z2901550610/Min_Sum/docs/figures/c2v_state_read_pipeline.png

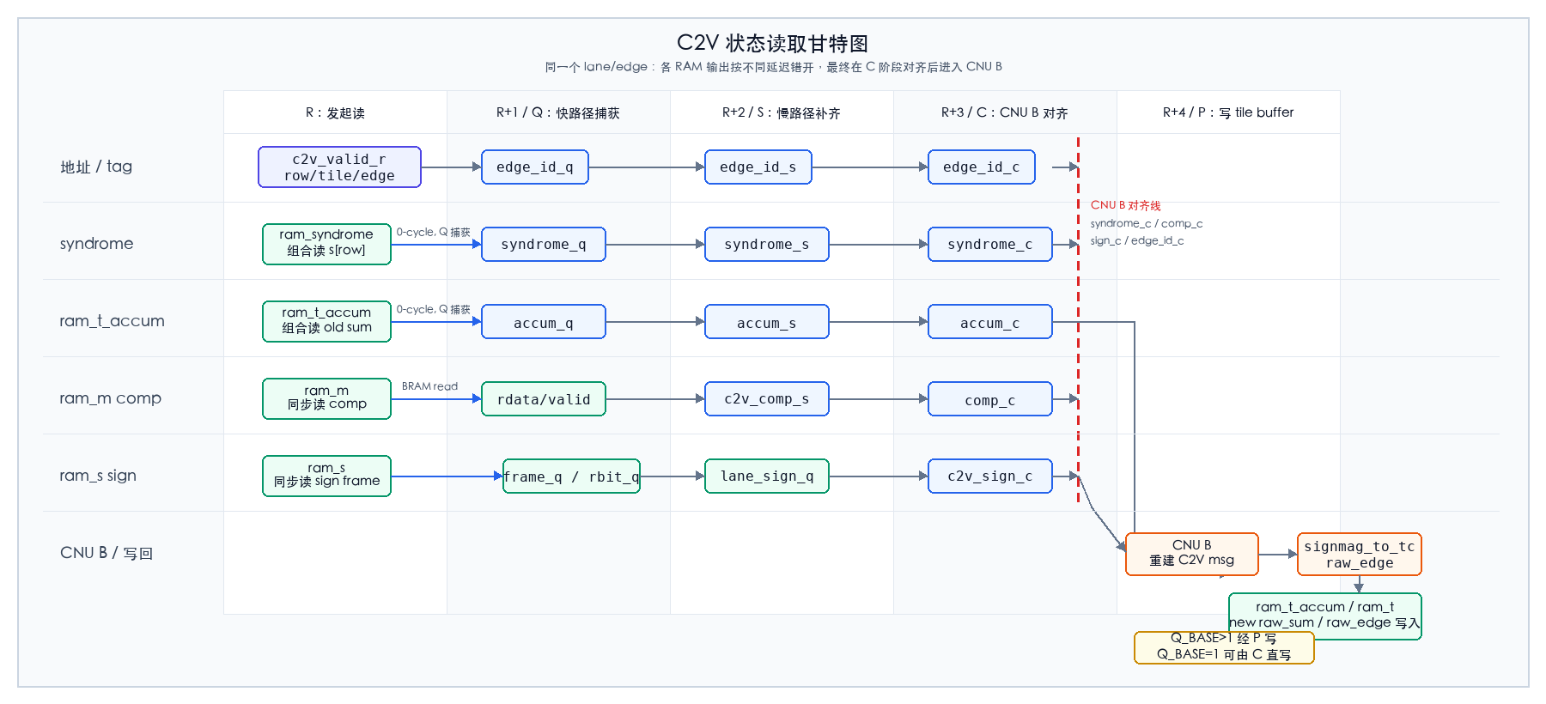
docs/figures/c2v_state_read_pipeline.png
