z2901550610/Min_Sum/docs/figures/decoder_datapath.png

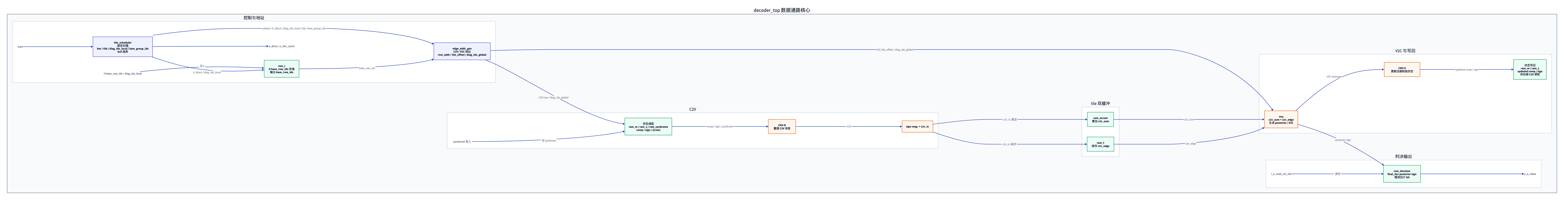
docs/figures/decoder_datapath.png
