z2901550610/Min_Sum/docs/figures/scheduler_window_pipeline.png

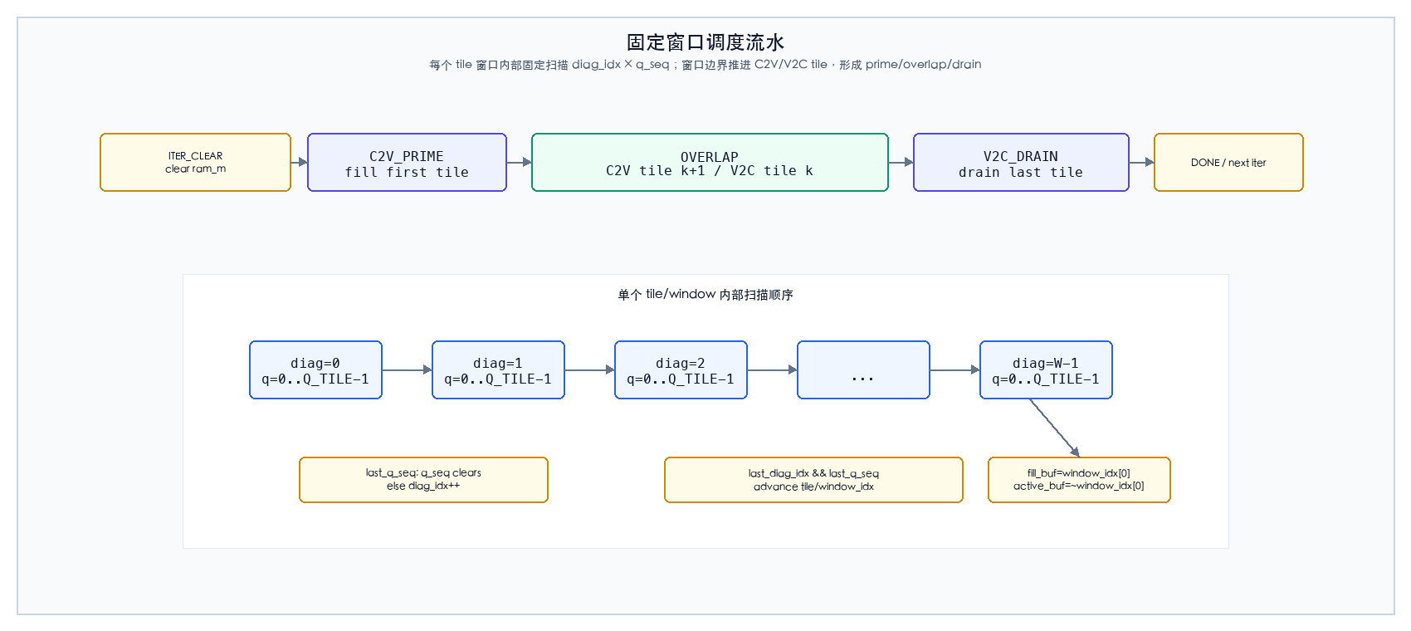
docs/figures/scheduler_window_pipeline.png
