z2901550610/Min_Sum/docs/figures/tile_buffer_pingpong.png

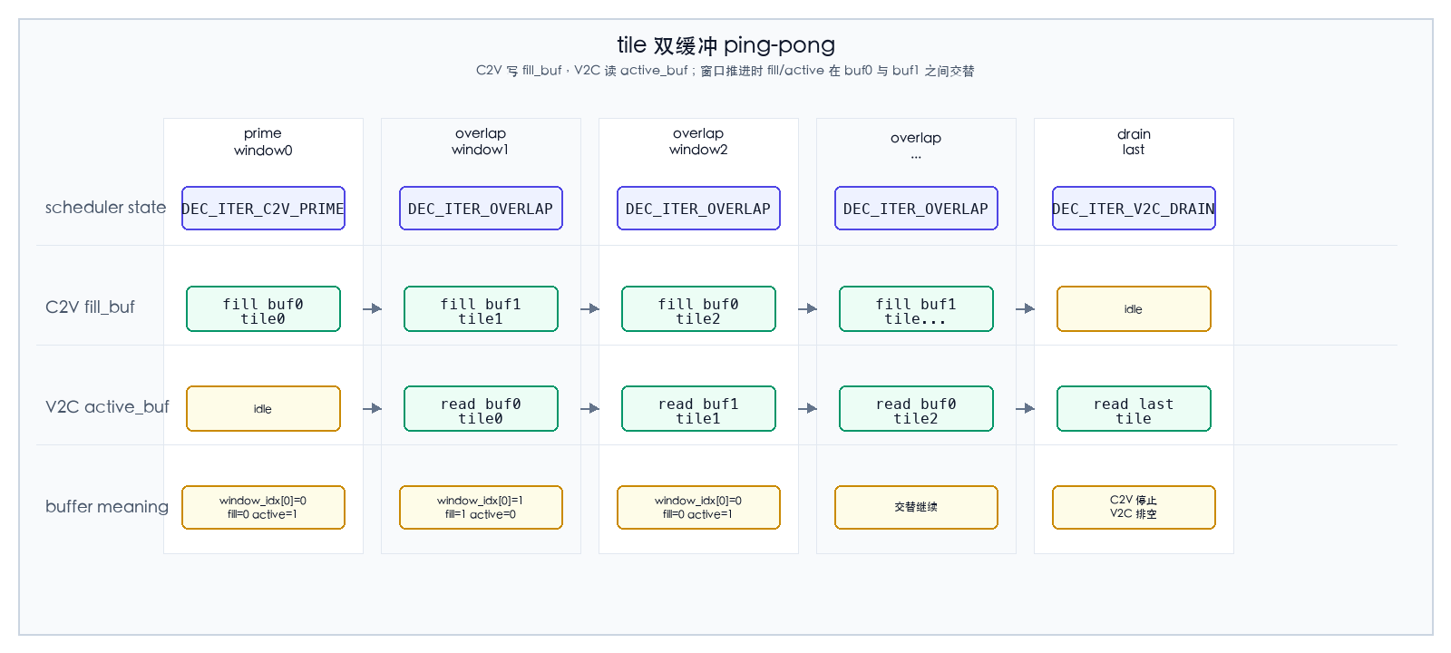
docs/figures/tile_buffer_pingpong.png
