z2901550610/Min_Sum/docs/figures/trike160_full_ksign_k3_k4_logdfr.png

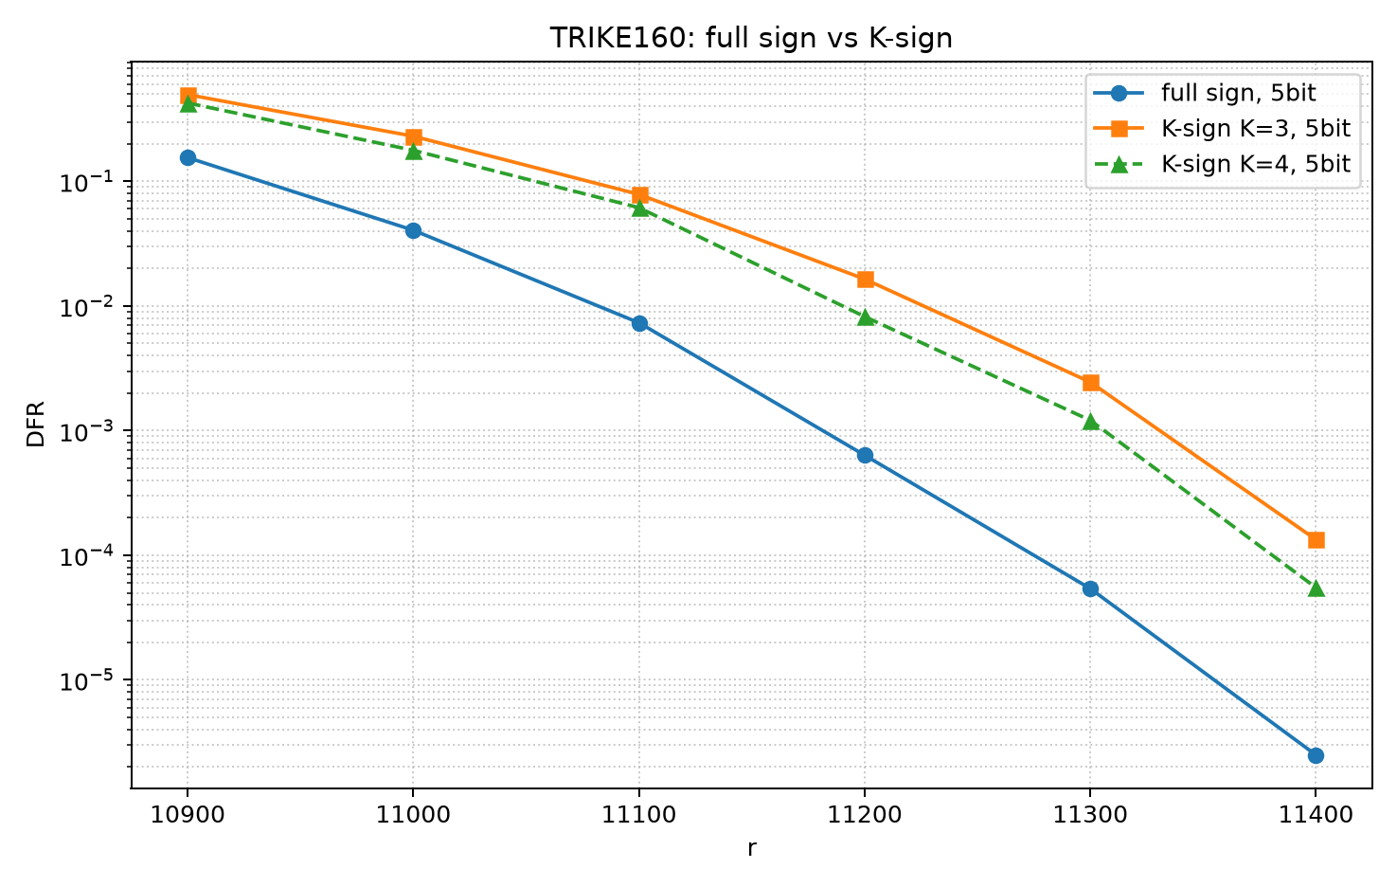
docs/figures/trike160_full_ksign_k3_k4_logdfr.png
