z2901550610/Min_Sum/docs/figures/trike384_full_ksign_k3_k4_logdfr.png

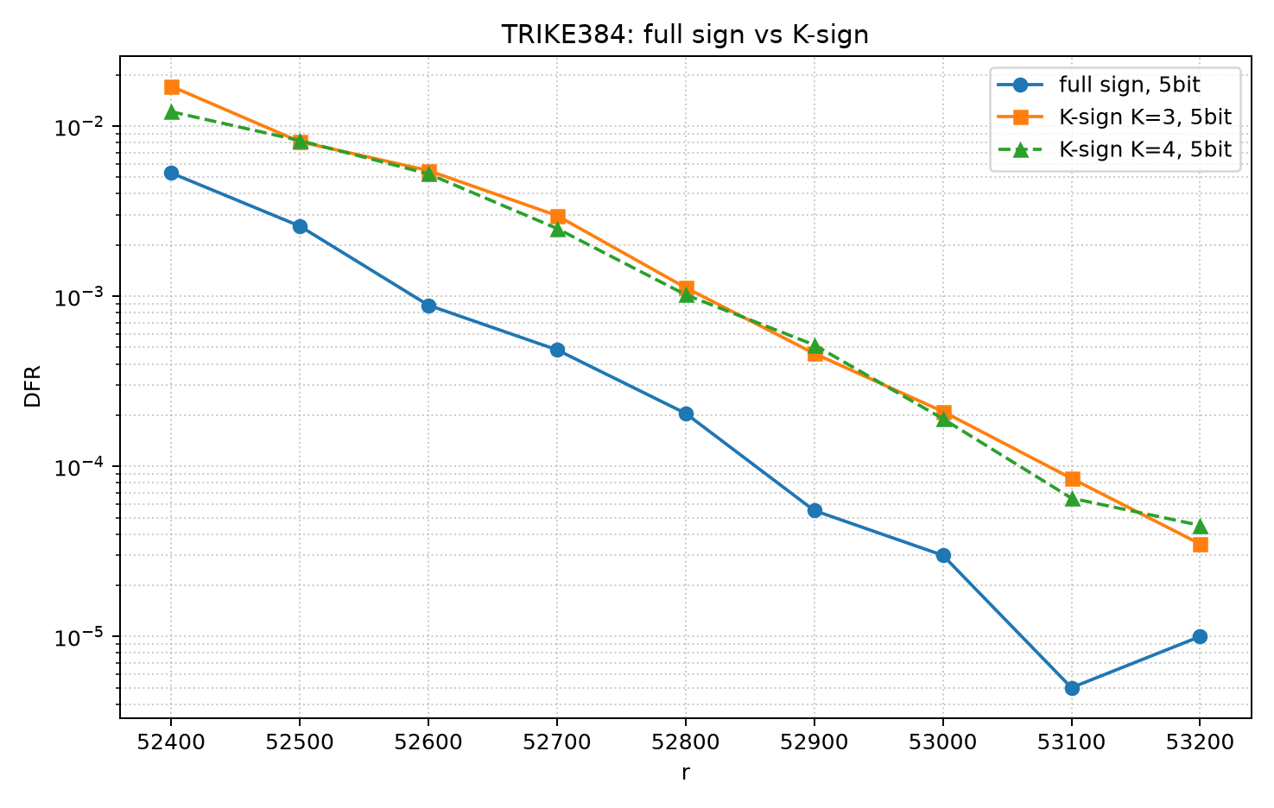
docs/figures/trike384_full_ksign_k3_k4_logdfr.png
