z2901550610/Min_Sum/docs/figures/trike512_full_k6_k4_logdfr_no_upper.png

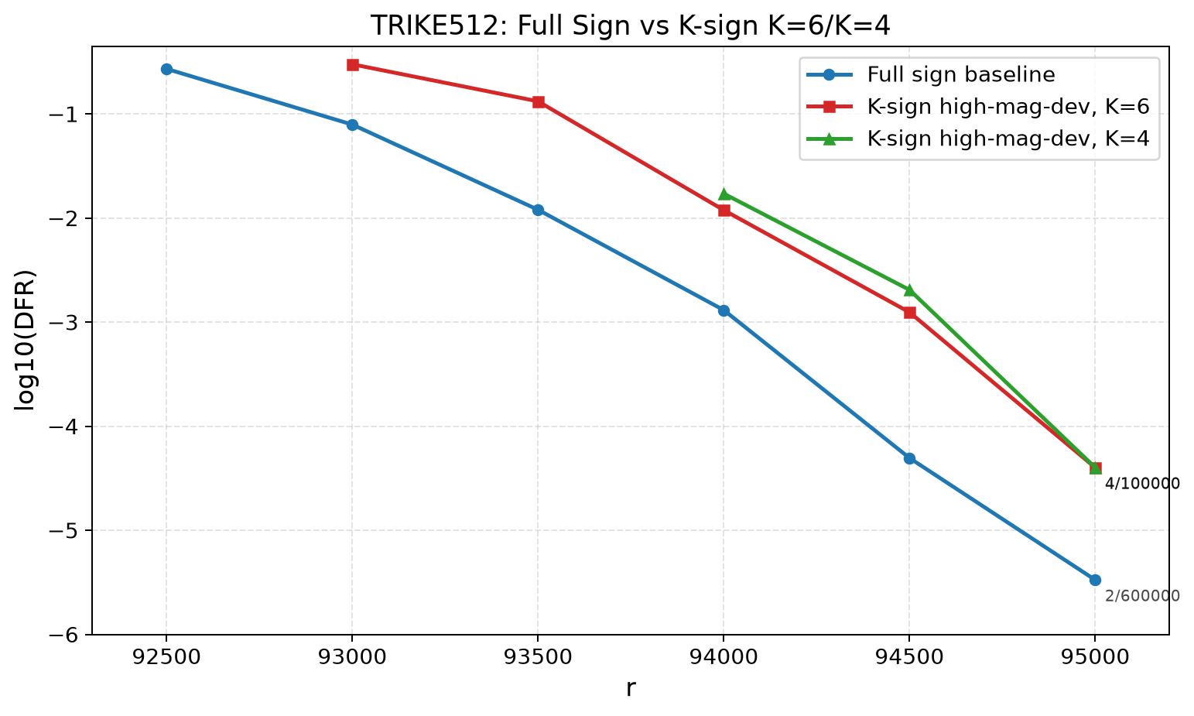
docs/figures/trike512_full_k6_k4_logdfr_no_upper.png
