z2901550610/Min_Sum/docs/figures/v2c_update_pipeline.png

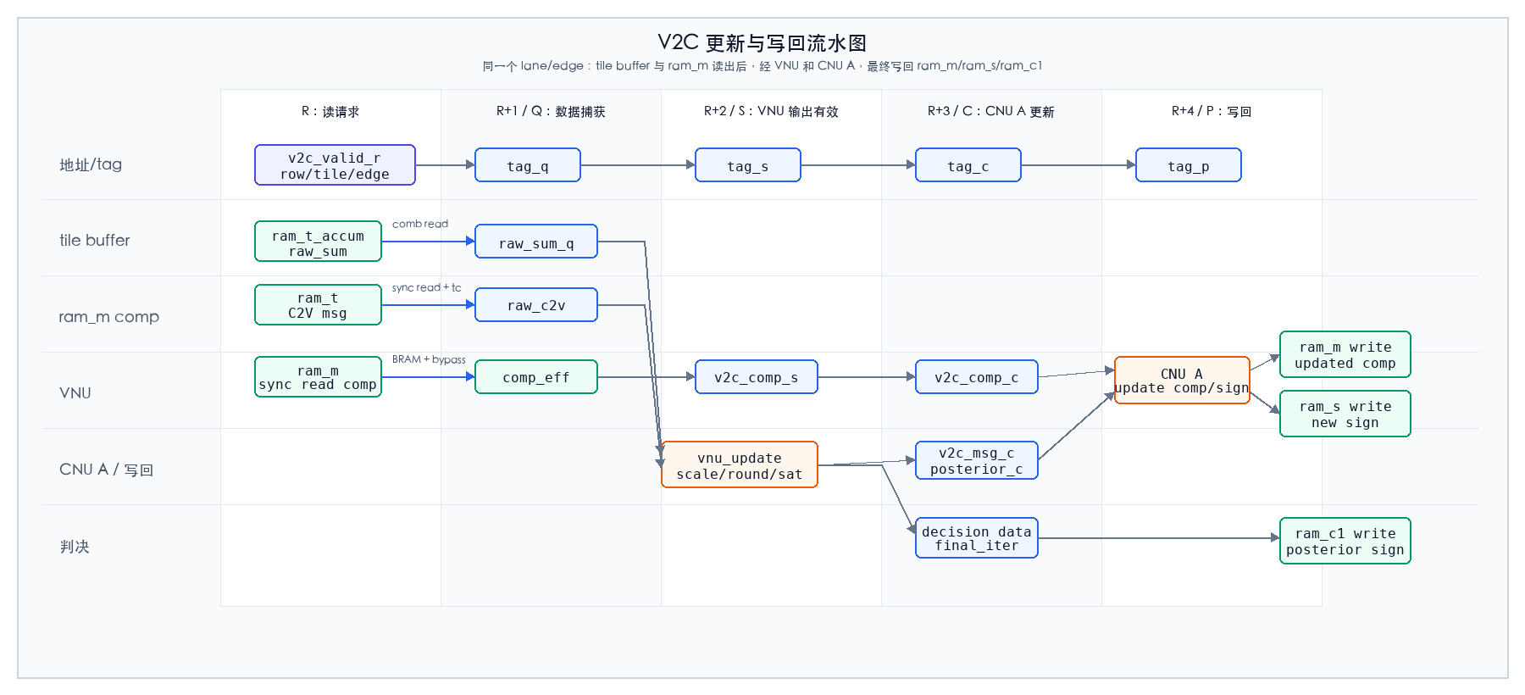
docs/figures/v2c_update_pipeline.png
