z2901550610/Min_Sum/docs/recovered/1_decoder top.recovered.png

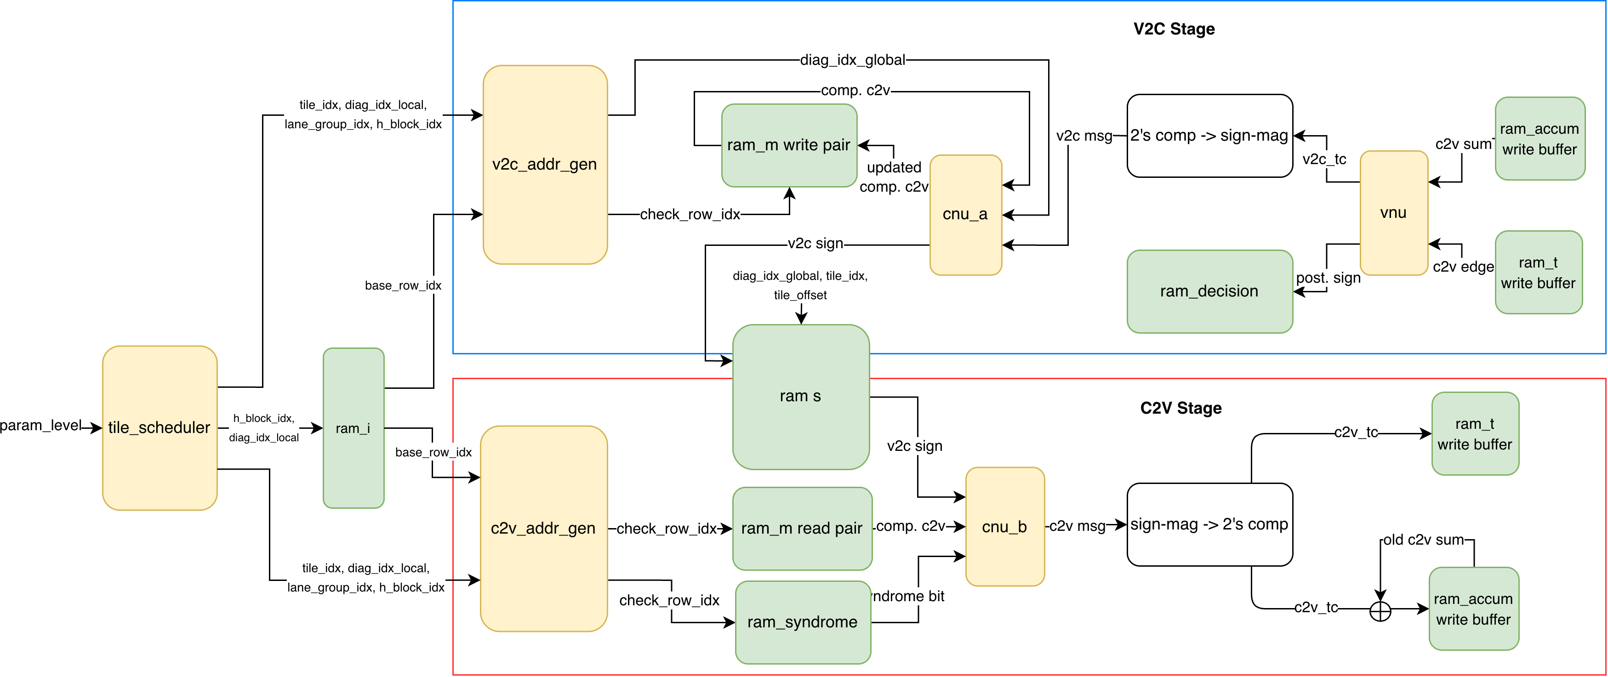
docs/recovered/1_decoder top.recovered.png
