z2901550610/Min_Sum/docs/verification/quantization_model.md

# QC-MDPC Min-Sum C Model

`scripts/min_sum_model.c` 是面向量化研究的固定迭代 QC-MDPC syndrome min-sum 模型。模型使用 C11，实现 BIKE profile、定重错误生成、消息饱和、RTL 对应舍入、逐轮统计和 CSV 汇总。

模型复现译码算法和定点数值规则，不复现 tile、bank、pipeline 和 cycle schedule。RTL 时序与固定周期预算继续由现有 testbench 验证。

## 构建

```bash
make model-min-sum
```

生成文件：

```text
build/model/min_sum_model
```

Linux 服务器也可以直接构建：

```bash
cc -O3 -std=c11 -Wall -Wextra -Wpedantic \
  -pthread scripts/min_sum_model.c -o min_sum_model
```

## 基本运行

运行一个 BIKE-128 case：

```bash
build/model/min_sum_model --profile bike128 --seed 1 --trials 1
```

运行一个 TRIKE-160 case：

```bash
build/model/min_sum_model --profile trike160 --seed 1 --trials 1
```

TRIKE profile：

| Profile | n0 | r | w | t | Iterations |
| --- | ---: | ---: | ---: | ---: | ---: |
| `trike160` | 3 | 12589 | 35 | 263 | 7 |
| `trike256` | 3 | 30389 | 55 | 429 | 7 |
| `trike384` | 3 | 63773 | 83 | 659 | 7 |
| `trike512` | 3 | 106781 | 111 | 877 | 7 |

输出逐轮消息统计：

```bash
build/model/min_sum_model \
  --profile bike128 \
  --seed 1 \
  --trials 1 \
  --stats
```

保存多次 trial 的汇总：

```bash
build/model/min_sum_model \
  --profile bike128 \
  --seed 1 \
  --trials 100 \
  --threads 16 \
  --csv build/model/bike128.csv
```

`--threads` 按 trial 并行。每个 worker 拥有独立 H、错误向量和消息缓冲区，最终结果按 trial 编号输出。同一 seed 区间在单线程和多线程运行中产生相同的译码结果。

使用 Linux 在线 CPU 数量：

```bash
build/model/min_sum_model \
  --profile bike128 \
  --seed 1 \
  --trials 1000 \
  --threads 0
```

启动信息中的 `worker_memory_mib` 和 `total_worker_memory_mib` 给出主要缓冲区估算。总内存需求近似为：

```text
threads * worker_memory_mib
```

BIKE-256 和高线程数需要先确认服务器内存容量。`--stats` 输出逐轮直方图，只允许配合 `--threads 1` 使用。

## 量化参数

消息位宽包含 1 bit 符号和其余 magnitude bit。4-bit 消息对应 3-bit magnitude：

```bash
build/model/min_sum_model \
  --profile bike128 \
  --msg-bits 4 \
  --c-val 5 \
  --alpha-shift-0 3 \
  --alpha-shift-1 4 \
  --trials 10
```

缩放因子定义为：

```text
alpha = 2^(-alpha_shift_0) + 2^(-alpha_shift_1)
```

模型使用 6-bit 小数缩放和 round-half-away-from-zero。V2C 更新结果以配置的消息幅度上限饱和。主循环固定执行 `--iterations` 指定的轮数。

## 模型数据流

每轮执行：

1. 由全部 V2C 消息计算每个 check 的 `min1`、`min2`、`min_diag_idx_global` 和 `sign_xor`。
2. 根据 syndrome 和 extrinsic sign 重建全部 C2V 消息。
3. 累加每个 variable 的 C2V 总和。
4. 计算 posterior 和下一轮 V2C 消息。
5. 在指定迭代预算结束后计算 error estimate 和 residual syndrome。

随机 case 由 SplitMix64 生成。同一可执行文件、配置和 seed 产生相同的 H 支撑集及错误位置，适合在服务器上复现实验。

## 第一组实验

先分别搜索 5-bit、4-bit 和 3-bit 均匀量化参数。每种位宽都需要搜索合法的 `C` 和 `alpha`：

```text
msg_bits = 5, 4, 3
C        = 1 .. 2^(msg_bits-1)-1
shift    = 1 .. 6
```

使用相同的 seed 区间比较候选配置，并记录：

- `syndrome_success`
- `exact`
- `decision_weight`
- `residual_weight`
- 每轮 V2C/C2V magnitude histogram
- saturation rate
- `min1 == min2` 比例

这些统计用于选择非均匀 reconstruction level 和 quantization threshold。

## C/RTL 共享 fixture

共享 fixture 包含 H 第一列支撑集、错误位置、syndrome 位置和全部定点参数。自动对拍命令：

```bash
make check-model-rtl
```

脚本使用同一个 fixture 运行 C 模型和 Verilator，并比较完整 error estimate 中所有非零列位置。对拍允许 case 译码失败，因为验证目标是两个实现产生完全相同的判决。

BIKE-128 完整参数对拍：

```bash
make check-model-rtl-bike128
```

保留中间 fixture、生成 testbench 和判决文件：

```bash
python3 scripts/check_model_rtl.py \
  --seed 2 \
  --r 8 \
  --w 3 \
  --errors 1 \
  --keep-dir build/model/diff_case
```

C 模型也可以单独读取 fixture：

```bash
build/model/min_sum_model \
  --fixture-in build/model/diff_case/case.fixture \
  --decision-out build/model/diff_case/c.decision
```

## 参数扫描

`scripts/run_quantization_experiment.py` 是量化实验入口。`sweep` 子命令逐个枚举消息位宽、`C` 和两个 alpha shift。每个候选配置内部使用 C 模型的多线程 trial：

```bash
python3 scripts/run_quantization_experiment.py sweep \
  --profile trike160 \
  --msg-bits 3,4,5 \
  --seed 1 \
  --trials 1000 \
  --threads 32 \
  --output build/model/trike160_sweep.csv
```

shift pair 只枚举 `shift_0 <= shift_1`，避免交换顺序造成重复配置。扫描结果包含成功数、精确恢复数、平均 residual weight 和运行时间。大规模实验可以先用 20～100 个 trial 粗筛，再对候选配置使用相同 seed 区间扩大 trial 数。

当前 C 模型扫描使用 profile 定义的固定 `r` 单点。TRIKE-160 使用：

```text
n0 = 3
r  = 12589
w  = 35
t  = 263
```

量化参数搜索不枚举 r 区间。r 区间曲线和 DFR 估计使用 myTRIKE Monte Carlo 流程。

## Linux 服务器一键实验

`campaign` 子命令自动完成 3/4/5-bit 全参数粗筛、候选参数验证、压力测试和结果汇总：

```bash
make model-min-sum

python3 scripts/run_quantization_experiment.py campaign \
  --profile trike160 \
  --mode quick \
  --threads 32
```

使用全部在线 CPU：

```bash
python3 scripts/run_quantization_experiment.py campaign --profile trike160 --threads 0
```

三种实验规模：

| Mode | 粗筛 trials/配置 | 目标重量 trials | 每个压力点 trials |
| --- | ---: | ---: | ---: |
| `smoke` | 2 | 20 | 20 |
| `quick` | 20 | 1000 | 500 |
| `full` | 100 | 10000 | 5000 |

正式服务器实验：

```bash
mkdir -p results

nohup python3 scripts/run_quantization_experiment.py campaign \
  --profile trike160 \
  --mode full \
  --threads 32 \
  --out-dir results/trike160_full \
  > results/trike160_full.log 2>&1 &
```

查看进度：

```bash
tail -f results/trike160_full.log
```

主要结果：

```text
results/trike160_full/coarse_sweep.csv
results/trike160_full/candidate_results.csv
results/trike160_full/summary.md
```

## 完整网格最优参数

`optimum` 子命令枚举完整均匀量化网格并排序。搜索范围为：

```text
msg_bits = 3, 4, 5
C        = 1 .. 2^(msg_bits-1)-1
shift    = 1 .. 6, shift_0 <= shift_1
```

TRIKE-160 完整网格：

```bash
make model-min-sum

python3 scripts/run_quantization_experiment.py optimum \
  --profile trike160 \
  --trials 10000 \
  --threads 32 \
  --out-dir results/trike160_optimum_10k
```

结果文件：

```text
results/trike160_optimum_10k/exhaustive_sweep.csv
results/trike160_optimum_10k/summary.md
```

`summary.md` 给出每个位宽的最优候选和 top 排名。该结论对应当前均匀量化网格和有限 seed 区间。DFR 估计使用 myTRIKE Monte Carlo 流程扩大试验规模。

TRIKE-160 参数使用 `n0=3, r=12589, w=35, t=263, iterations=7, C_VAL=4`。切换到
TRIKE-160：

```bash
nohup python3 scripts/run_quantization_experiment.py campaign \
  --profile trike160 \
  --mode full \
  --threads 32 \
  --out-dir results/trike160_full \
  > results/trike160_full.log 2>&1 &
```

## 候选参数复核

`confirm` 子命令用于比较少量近邻候选。默认候选为：

```text
3-bit: C = 2, 3
4-bit: C = 5, 6, 7
5-bit: C = 5, 13, 15
alpha = 2^-3 + 2^-4
```

本地 smoke：

```bash
make model-min-sum

python3 scripts/run_quantization_experiment.py confirm \
  --profile trike160 \
  --mode smoke \
  --threads 4 \
  --out-dir build/model/confirm/trike160_smoke
```

服务器复核：

```bash
python3 scripts/run_quantization_experiment.py confirm \
  --profile trike160 \
  --mode full \
  --threads 32 \
  --out-dir results/trike160_confirm_full
```

输出文件：

```text
results/trike160_confirm_full/candidate_results.csv
results/trike160_confirm_full/summary.md
```

也可以指定候选：

```bash
python3 scripts/run_quantization_experiment.py confirm \
  --profile trike160 \
  --mode full \
  --candidate 4:6:3:4 \
  --candidate 4:7:3:4 \
  --threads 32
```
