z2901550610/Min_Sum/docs/verification/k4_minsum_trike_bf_fls_extrapolation.md

# K=4 Min-Sum 与 TRIKE BF 的 DFR 有限长度外推说明

> 数据版本：2026-08-02
> 分析对象：5-bit、K=4、`high_mag_dev` Min-Sum 与 TRIKE 文档中的 Bit-Flipping 译码器  
> 目的：统一说明外推方法、95% 置信度处理、外推结果、比较口径及验证边界

## 1. 结论摘要

按照 Amraoui 等提出的有限长度缩放（Finite-Length Scaling，FLS）思想，并采用 TRIKE 文档中的 95% Clopper-Pearson 置信区间和点对外推方法，当前 K=4 Min-Sum 数据得到以下结果：

| 实例/参数组 | 目标 DFR | TRIKE BF 外推 `r` | K=4 Min-Sum 连续交点 `r*` | K=4 Min-Sum 建议合法 `r` | Min-Sum 在建议 `r` 下的 95% DFR 上界 |
|---|---:|---:|---:|---:|---:|
| TRIKE-2 / TRIKE160 | `2^-128` | 15541[^trike2-r] | 12576.5 | **12589** | `2^-129.52` |
| TRIKE-3 / TRIKE192 | `2^-192` | 22003 | — | **待补数据** | — |
| TRIKE-5 / TRIKE256 | `2^-256` | 35363 | 30358.0 | **30389** | `2^-258.25` |
| TRIKE-7 / TRIKE384 | `2^-384` | 69691 | 63735.2 | **63773** | `2^-386.07` |
| TRIKE-9 / TRIKE512 | `2^-512` | 114043 | 106755.6 | **106781** | `2^-513.76` |

这里的“建议合法 `r`”不是简单按百位取整，而是从连续交点 `r*` 向上搜索满足 TRIKE 环参数要求的候选：

- `r` 为素数；
- 2 是模 `r` 的本原元。

当前四个提交参数组都有完整 K=4 数据，并在 FLS 模型下达到相应目标 DFR。TRIKE192/TRIKE-3 没有 K=4 瀑布区数据，因此不能按相同方法给出结果。

### 1.1 RTL 参数集成状态

上述四个提交档“建议合法 `r`”已写入统一 TRIKE K-sign 硬件参数表、随机回归生成器和 C 参考模型：

```text
P_R_VALS = {12589, 30389, 63773, 106781}
P_C_VALS = {4, 5, 5, 7}
```

默认硬件保持 5-bit、K=4、7 次固定迭代、`L=32`、`COLS_PER_TILE=1152`。四档 seed 1 完整随机回归
均为 `residual=0`、`exact=1`，固定周期分别为337245、1252957、3866092和8538564。
参数替换没有引入固定 BF/BGF 阈值；相关软件译码器仍应针对具体 `r` 走原有自动阈值计算。

这表示硬件和验证工具采用同一组 K=4 外推候选参数，不表示已经用 Vivado 重新测得资源或时序，也不改变
本说明第 6 节列出的极低 DFR、安全证明和 error-floor 验证边界。

## 2. 外推方法

### 2.1 有限长度缩放关系

Amraoui 等针对迭代译码瀑布区给出的有限长度缩放关系表明，错误率曲线可以用高斯 Q 函数的缩放形式近似描述。TRIKE 文档针对 QC-MDPC 译码采用：

$$
\mathrm{DFR}
=
Q\left(
\frac{\sqrt{n}\left(C(\sigma)-C(\sigma^\ast)\right)}{\alpha}
\right).
$$

对于三循环块 TRIKE：

$$
n=3r,\qquad C(\sigma)=1-\frac{t}{n}.
$$

对 DFR 应用逆 Q 函数，可得：

$$
\frac{Q^{-1}(\mathrm{DFR})}{\sqrt{n}}
=
-\frac{t}{\alpha}\frac{1}{n}
+
\frac{1-C(\sigma^\ast)}{\alpha}.
$$

定义

$$
x=\frac{1}{n},\qquad
y=\frac{Q^{-1}(\mathrm{DFR})}{\sqrt{n}},
$$

则有近似线性关系：

$$
y=ax+b.
$$

因此，可以利用可观测的瀑布区 DFR 数据在 `(x,y)` 域进行线性外推，而不是直接在 `(r, log2(DFR))` 域做全局直线拟合。

### 2.2 95% Clopper-Pearson 区间

在某个参数 `r` 下，进行 `N` 次独立译码试验并观察到 `F` 次失败：

$$
F\sim\operatorname{Bin}(N,\theta),
$$

其中 `θ` 为真实 DFR。按照 TRIKE 文档，使用双侧 95% Clopper-Pearson 区间：

$$
\theta_- =
B^{-1}(0.025;F,N-F+1),
$$

$$
\theta_+ =
B^{-1}(0.975;F+1,N-F).
$$

将 DFR 区间端点转换到

$$
y=\frac{Q^{-1}(\mathrm{DFR})}{\sqrt n}
$$

时，需要注意 `Q^-1` 单调递减：

- DFR 上界 `θ+` 对应 `y` 的数值下界；
- DFR 下界 `θ-` 对应 `y` 的数值上界。

本说明按照“真实 DFR 的 95% 上置信界”进行判断，避免把 `y` 的数值上界误当成 DFR 上界。

### 2.3 点对外推

对于任意满足

$$
r_i<r_j<r_{\mathrm{test}}
$$

的两个实测点，令

$$
x_i=\frac{1}{3r_i},\qquad
x_j=\frac{1}{3r_j},\qquad
x_{\mathrm{test}}=\frac{1}{3r_{\mathrm{test}}},
$$

并定义

$$
A=\frac{x_j-x_{\mathrm{test}}}{x_i-x_j}>0.
$$

中心值的线性外推为：

$$
y_{\mathrm{test}}=(1+A)y_j-Ay_i.
$$

置信边界通过两个实测点区间端点的最坏组合获得。对所有有效点对重复计算后，选择给出最紧 DFR 上界的点对，并求解该上界首次达到目标 DFR 时的连续交点 `r*`。

## 3. TRIKE Bit-Flipping 外推结果

TRIKE 文档将 Bit-Flipping 译码固定为 7 次迭代，并给出以下 95% 置信水平的 FLS 外推结果：

| 实例 | 经典/量子安全强度 | 外推 `r` | 目标 DFR | 外推 `log2(DFR)` | 相对目标的模型余量 |
|---|---:|---:|---:|---:|---:|
| TRIKE-2 | 128 / 80 bit | 15541[^trike2-r] | `2^-128` | -128.41 | 0.41 bit |
| TRIKE-3 | 192 / 96 bit | 22003 | `2^-192` | -195.64 | 3.64 bit |
| TRIKE-5 | 256 / 128 bit | 35363 | `2^-256` | -256.44 | 0.44 bit |
| TRIKE-7 | 384 / 192 bit | 69691 | `2^-384` | -431.23 | 47.23 bit |
| TRIKE-9 | 512 / 256 bit | 114043 | `2^-512` | -525.71 | 13.71 bit |

TRIKE-2 和 TRIKE-5 的外推结果基本贴近目标线；TRIKE-3 有约 3.64 bit 余量；TRIKE-7 和 TRIKE-9 的模型余量较大。

[^trike2-r]: TRIKE 文档表 1 给出的 TRIKE-2 推荐参数为 `r=15581`，表 8 的 DFR 外推结果使用 `r=15541`，两处相差 40。本说明为了复现表 8，BF 外推列采用 `15541`；正式引用前应由文档作者确认。

## 4. K=4 Min-Sum 的数据与外推结果

### 4.1 仿真设置

本次外推只使用以下 Min-Sum 配置：

| 项目 | 设置 |
|---|---|
| 译码器 | `hw_quant_ms` |
| 消息位宽 | 5 bit |
| 小数位宽 | 0 bit |
| 初始 LLR | TRIKE160：4；TRIKE256/384：5；TRIKE512：7 |
| 最大迭代次数 | 7 |
| 仿真收敛处理 | 综合征首次为零时结束该trial；硬件仍执行固定7轮 |
| 符号方案 | `high_mag_dev` |
| `K` | 4 |
| 基准符号 | `decision` |
| Top-K 相等幅值规则 | `low_index` |
| `alpha` | TRIKE160/256：0.1875；TRIKE384：0.140625；TRIKE512：0.0625 |

外推没有混用 `full_sign`、K=3、K=6 或 4-bit 数据。

### 4.2 各参数组结果

| 参数组 | K=4 实测 `r` 范围 | 最终外推点对 | 连续交点 `r*` | 建议合法 `r` | 建议 `r` 下的 95% DFR 上界 |
|---|---:|---:|---:|---:|---:|
| TRIKE160 | 10900–11100 | 10900 / 11100 | 12576.5 | **12589** | `2^-129.52` |
| TRIKE192 | 无数据 | — | — | **待补** | — |
| TRIKE256 | 24800–25200 | 24800 / 25200 | 30358.0 | **30389** | `2^-258.25` |
| TRIKE384 | 52400–53300 | 52600 / 53100 | 63735.2 | **63773** | `2^-386.07` |
| TRIKE512 | 94000–95500 | 94500 / 95100 | 106755.6 | **106781** | `2^-513.76` |

TRIKE160使用
`alpha=0.1875`和初始LLR 4：`r=10900`为719/10000失败，`r=11100`为
2907/2000000失败，双侧95% Clopper–Pearson区间分别为
`[6.691e-2, 7.714e-2]`和`[1.401e-3, 1.507e-3]`。TRIKE256固定
`alpha=0.1875`和初始LLR 5：`r=24800`为154/10000失败，`r=25200`为
392/2000000失败，双侧95% Clopper–Pearson区间分别为
`[1.308e-2, 1.801e-2]`和`[1.771e-4, 2.164e-4]`。TRIKE384固定
`alpha=0.140625`和初始LLR 5：`r=52600`为45/10000失败，`r=53100`为
179/2000000失败，双侧95% Clopper–Pearson区间分别为
`[3.284e-3, 6.017e-3]`和`[7.687e-5, 1.036e-4]`。其他参数组的点对按照点对
置信区间外推得到。所有结果均在FLS变换域计算，不直接对 `log2(DFR)` 做直线拟合。

### 4.3 TRIKE512 零失败数据

TRIKE512 的 K=4 数据中：

- `r=95200、95300、95400`：各 500000 次试验、零失败；
- `r=95500`：累计 600000 次试验、零失败。

零失败不等于真实 DFR 为零：

| 试验数 | 失败数 | 95% Clopper-Pearson DFR 上界 | 约合 `log2` |
|---:|---:|---:|---:|
| 500000 | 0 | `7.38e-6` | -17.05 |
| 600000 | 0 | `6.15e-6` | -17.31 |

这些上界与 `2^-512` 相差极大，因此零失败点不能直接证明目标 DFR。TRIKE512 的最终外推点对采用仍有正失败计数的 `r=94500` 和 `r=95100`；后续零失败点只用于检查实测趋势是否出现明显反向异常。

### 4.4 TRIKE192 数据缺口

当前汇总表没有 TRIKE192/TRIKE-3 的 K=4 Min-Sum 数据，因此不能按照同一 FLS 方法给出其 `r`。

为了补齐该等级，需要：

1. 使用与其他等级一致的 K=4、5-bit、7 次固定迭代设置；
2. 选择一组覆盖瀑布区的 `r` 网格；
3. 使数据覆盖约 `10^-2` 至 `10^-5` 的 DFR 范围；
4. 保留多个具有正失败计数的点，而不是只获得零失败点；
5. 使用相同的 95% Clopper-Pearson 和点对外推流程重新计算。

## 5. Min-Sum 与 BF 的结果比较

| 实例/参数组 | TRIKE BF `r` | K=4 Min-Sum 建议 `r` | `r` 绝对变化 | `r` 相对变化 |
|---|---:|---:|---:|---:|
| TRIKE-2 / TRIKE160 | 15541[^trike2-r] | 12589 | -2952 | -19.0% |
| TRIKE-3 / TRIKE192 | 22003 | 待补 | — | — |
| TRIKE-5 / TRIKE256 | 35363 | 30389 | -4974 | -14.1% |
| TRIKE-7 / TRIKE384 | 69691 | 63773 | -5918 | -8.5% |
| TRIKE-9 / TRIKE512 | 114043 | 106781 | -7262 | -6.4% |

按照当前模型，K=4 Min-Sum 在四个提交参数组上达到目标 DFR 所需的 `r` 均小于 TRIKE 文档中的 BF 外推参数，相对差距由低等级的约19%逐渐收窄到高等级的约6.4%。

这一结果只能解释为：

> 在当前译码设置和现有瀑布区数据下，K=4 Min-Sum 的经验 FLS 外推交点比 TRIKE 文档中的 BF 交点更靠左。

不能直接解释为：

- 已经证明可以把最终密码参数 `r` 缩小相同比例；
- Min-Sum 在相同密钥和错误实例上一定优于 BF；
- Min-Sum 的硬件面积、译码周期或总延迟一定更低；
- 已经排除弱密钥、结构化错误和 error floor。

BF 与 Min-Sum 使用不同的消息更新方式、阈值/归一化参数和经验数据。上述比较是“各自模型达到同一目标 DFR 所需的 `r`”之间的比较，不是共享随机实例上的配对 A/B 试验。

## 6. 外推结果的适用边界

### 6.1 当前结果能够支持的结论

1. Amraoui FLS 变换可将当前 Min-Sum 瀑布区 DFR 数据映射到近似线性的 `(1/n, Q^-1(DFR)/√n)` 坐标域。
2. 在逐点 95% Clopper-Pearson 置信区间和点对外推规则下，现有四个提交参数组均能达到相应目标 DFR。
3. 向上取到满足 TRIKE 环参数约束后，K=4 Min-Sum 的候选 `r` 为：
   - TRIKE160：12589；
   - TRIKE256：30389；
   - TRIKE384：63773；
   - TRIKE512：106781。
4. 在当前模型口径下，这些 `r` 小于 TRIKE 文档中的 BF 外推结果。

### 6.2 当前结果不能单独证明的事项

| 边界 | 说明 |
|---|---|
| 极低 DFR 的直接验证 | 当前试验数不足以直接观察 `2^-128` 至 `2^-512` 事件，结论依赖瀑布区模型 |
| Error floor | FLS 可能无法覆盖结构化错误模式或小吸收结构形成的错误平台 |
| 弱密钥 | 典型随机实例外推不能替代弱密钥筛选和边界密钥专项验证 |
| 同时置信覆盖 | 95% Clopper-Pearson 是逐点区间，点对选择和多重比较没有进一步校正 |
| Min-Sum/BF 配对优劣 | 两组结果来自不同试验，尚未进行共享密钥和错误实例的配对比较 |
| 硬件收益 | DFR 外推不能替代固定周期、BRAM、LUT、时钟频率和时序测量 |
| 最终密码参数 | 最终定稿还需要检查攻击复杂度、代数条件、弱密钥策略和安全证明 |

## 7. 建议的后续验证

1. **补齐 TRIKE192：**获取覆盖完整瀑布区的 K=4 数据。
2. **候选参数邻域复核：**在建议 `r` 的下方、候选点和上方分别补跑，检查单调性和 FLS 残差。
3. **配对比较 BF 与 Min-Sum：**对相同密钥、错误向量和随机种子执行配对试验。
4. **检查结构性失败：**对弱密钥、边界密钥和可能的 error floor 开展专项长程仿真。
5. **联合硬件评估：**同时比较固定译码周期、可达频率、LUT、FF、BRAM 和总体延迟。
6. **最终参数复核：**在采用较小 `r` 前重新评估攻击复杂度、环参数合法性和完整安全证明。

## 8. 数据与参考资料

1. Abdelaziz Amraoui, Andrea Montanari, Tom Richardson, Rüdiger Urbanke, “Finite-Length Scaling for Iteratively Decoded LDPC Ensembles,” *IEEE Transactions on Information Theory*, 55(2), 2009。
   - 文件：`/Users/z2901550610/Zotero/storage/WXJUMIHI/Amraoui 等 - 2009 - Finite-length scaling for iteratively decoded LDPC ensembles.pdf`
2. `TRIKE_document_newtemplate-6.pdf`，重点参考第 10 页参数表和第 13–15 页 DFR 外推方法及表 8。
   - 文件：`/Users/z2901550610/Library/CloudStorage/GoogleDrive-z2901550610@gmail.com/其他计算机/我的windows/JiuCuoMa/TRIKE/bf/TRIKE_document_newtemplate-6.pdf`
3. 本项目 K-sign DFR 汇总：
   - [`ksign_results_summary.csv`](../figures/ksign_results_summary.csv)

本文档中的 Min-Sum 数值属于当前数据快照下的统计外推结果。若修改消息位宽、`K`、`alpha`、迭代次数、Top-K tie 规则、错误生成方式或试验数据，应重新执行完整外推。
