z2901550610/Min_Sum/docs/figures/ksign_results_summary.csv

param_set | r | scheme | msg_bits | sign_k | trials | failures | dfr
trike160 | 10900 | full_sign | 5 |  | 1000 | 155 | 1.55000000e-01
trike160 | 11000 | full_sign | 5 |  | 2000 | 81 | 4.05000000e-02
trike160 | 11100 | full_sign | 5 |  | 6000 | 44 | 7.33333333e-03
trike160 | 11200 | full_sign | 5 |  | 63000 | 40 | 6.34920635e-04
trike160 | 11300 | full_sign | 5 |  | 500000 | 27 | 5.40000000e-05
trike160 | 11400 | full_sign | 5 |  | 2000000 | 5 | 2.50000000e-06
trike160 | 10900 | high_mag_dev | 5 | 3 | 1400 | 694 | 4.95714286e-01
trike160 | 11000 | high_mag_dev | 5 | 3 | 1400 | 322 | 2.30000000e-01
trike160 | 11100 | high_mag_dev | 5 | 3 | 1400 | 110 | 7.85714286e-02
trike160 | 11200 | high_mag_dev | 5 | 3 | 1400 | 23 | 1.64285714e-02
trike160 | 11300 | high_mag_dev | 5 | 3 | 9800 | 24 | 2.44897959e-03
trike160 | 11400 | high_mag_dev | 5 | 3 | 242200 | 40 | 1.65152766e-04
trike160 | 11500 | high_mag_dev | 5 | 3 | 775600 | 20 | 2.57864879e-05
trike160 | 10900 | high_mag_dev | 5 | 4 | 1400 | 595 | 4.25000000e-01
trike160 | 11000 | high_mag_dev | 5 | 4 | 1400 | 248 | 1.77142857e-01
trike160 | 11100 | high_mag_dev | 5 | 4 | 1400 | 86 | 6.14285714e-02
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
