z2901550610/Min_Sum/rtl/decoder_top.sv

`timescale 1ns / 1ps
// Top-level tiled min-sum decoder.
module decoder_top
  import bike_pkg::*;
(
    input  logic                    i_clk,
    input  logic                    i_rst_n,
    input  logic                    i_start,
    input  logic [PROFILE_ID_W-1:0] i_param_level,
    input  logic                    i_syndrome_we,
    input  logic [   ROW_IDX_W-1:0] i_syndrome_addr,
    input  logic                    i_syndrome_wdata,
    input  logic                    i_h_we,
    input  logic [   H_BLOCK_W-1:0] i_h_block_idx,
    input  logic [  DIAG_IDX_W-1:0] i_h_diag_idx_local,
    input  logic [   ROW_IDX_W-1:0] i_h_base_row_idx,
    input  logic [       COL_W-1:0] i_e_read_col_idx,
    input  logic [       COL_W-1:0] i_e_read_col_idx_1,
    input  logic                    i_e_read_valid_1,
    output logic                    o_h_loaded,
    output logic                    o_h_error,
    output logic                    o_done,
    output logic                    o_e_rdata,
    output logic                    o_e_rdata_1,
    output logic [      ITER_W-1:0] o_iter_count
);

  localparam bit C2V_WRITE_PIPELINE = (Q_BASE > 1);

`ifndef SYNTHESIS
  initial begin
    if ((L <= 0) || ((L & (L - 1)) != 0)) begin
      $fatal(1, "decoder_top requires L to be a power of two");
    end
    if ((COLS_PER_TILE <= 0) || ((COLS_PER_TILE >= L) && ((COLS_PER_TILE % L) != 0))) begin
      $fatal(
          1,
          "decoder_top requires COLS_PER_TILE to be positive and aligned to L when COLS_PER_TILE >= L");
    end
  end
`endif

  /* verilator lint_off UNUSEDSIGNAL */
  logic        [      DEC_STATE_W-1:0] state;
  logic        [        TILE_ID_W-1:0] unused_c2v_tile_linear;
  logic        [        TILE_ID_W-1:0] v2c_tile_linear;
  logic                                unused_iter_first_cycle;
  logic        [        ROW_IDX_W-1:0] unused_c2v_corr_check_row_idx[0:L-1];
  logic        [        ROW_IDX_W-1:0] unused_v2c_check_row_idx[0:L-1];
  logic        [    DIAG_GLOBAL_W-1:0] unused_c2v_corr_diag_idx_global_base;
  logic        [        ROW_IDX_W-1:0] unused_ksign_check_row_idx[0:L-1];
  logic        [    DIAG_GLOBAL_W-1:0] unused_ksign_diag_idx_global_base;
  logic        [    DIAG_GLOBAL_W-1:0] unused_ksign_diag_idx_global[0:L-1];
  logic        [       LANE_IDX_W-1:0] unused_ksign_row_bank[0:L-1];
  /* verilator lint_on UNUSEDSIGNAL */
  logic                                c2v_phase_active;
  logic                                v2c_phase_active;
  /* verilator lint_off UNUSEDSIGNAL */
  logic                                unused_ksign_corr_phase_active;
  /* verilator lint_on UNUSEDSIGNAL */
  logic                                ksign_overlap_start;
  logic                                ksign_overlap_done;
  logic                                ksign_overlap_phase;
  logic        [        H_BLOCK_W-1:0] ksign_overlap_h_block_idx;
  logic        [       TILE_IDX_W-1:0] ksign_overlap_tile_idx;
  logic        [       DIAG_IDX_W-1:0] ksign_overlap_diag_idx_local;
  logic        [ LANE_GROUP_IDX_W-1:0] ksign_overlap_lane_group_idx;
  logic        [        H_BLOCK_W-1:0] c2v_h_block_idx;
  logic        [       TILE_IDX_W-1:0] c2v_tile_idx;
  logic        [        H_BLOCK_W-1:0] v2c_h_block_idx;
  logic        [       TILE_IDX_W-1:0] v2c_tile_idx;
  logic        [       DIAG_IDX_W-1:0] active_diag_idx_local;
  logic        [ LANE_GROUP_IDX_W-1:0] active_lane_group_idx;
  logic                                fill_buf;
  logic                                active_buf;
  logic                                final_iter;
  logic                                iter_last_cycle;
  logic                                comp_clear_valid;
  logic        [      ROW_BANK_AW-1:0] comp_clear_addr;
  logic                                decode_start;
  logic                                decode_idle;
  logic                                h_load_write_enable;
  logic                                rst_n_sync;
  logic        [          CFG_R_W-1:0] cfg_r;
  logic        [          CFG_W_W-1:0] cfg_w;
  logic        [       TILE_IDX_W-1:0] cfg_tile_count;
  logic        [      ROW_BANK_AW-1:0] cfg_row_seg_size;
  logic        [       CFG_CVAL_W-1:0] cfg_c_val;
  logic        [CFG_ALPHA_SHIFT_W-1:0] cfg_alpha_shift_0;
  logic        [CFG_ALPHA_SHIFT_W-1:0] cfg_alpha_shift_1;
  logic        [     PROFILE_ID_W-1:0] param_level;
  logic        [     PROFILE_ID_W-1:0] param_level_in;
  logic        [     PROFILE_ID_W-1:0] profile_config_level;
  logic                                profile_locked;

  logic        [        ROW_IDX_W-1:0] c2v_h_base_row_idx;
  logic        [        ROW_IDX_W-1:0] v2c_h_base_row_idx;
  logic        [        ROW_IDX_W-1:0] ksign_h_base_row_idx;
  logic                                c2v_corr_valid[0:L-1];
  logic        [            COL_W-1:0] c2v_corr_col_idx[0:L-1];
  logic        [    DIAG_GLOBAL_W-1:0] c2v_corr_diag_idx_global[0:L-1];
  logic        [       LANE_IDX_W-1:0] c2v_corr_row_bank[0:L-1];
  logic        [      ROW_BANK_AW-1:0] c2v_corr_row_addr[0:L-1];
  logic        [       TILE_OFF_W-1:0] c2v_corr_tile_offset[0:L-1];

  logic                                c2v_phase_h;
  logic        [        H_BLOCK_W-1:0] c2v_h_block_idx_h;
  logic        [       TILE_IDX_W-1:0] c2v_tile_idx_h;
  logic        [       DIAG_IDX_W-1:0] c2v_diag_idx_local_h;
  logic        [ LANE_GROUP_IDX_W-1:0] c2v_lane_group_idx_h;
  logic                                c2v_fill_buf_h;
  logic                                c2v_iter_zero_h;
  logic                                comp_read_pair_sel_h;
  logic                                c2v_phase_e;
  logic        [        H_BLOCK_W-1:0] c2v_h_block_idx_e;
  logic        [       TILE_IDX_W-1:0] c2v_tile_idx_e;
  logic        [       DIAG_IDX_W-1:0] c2v_diag_idx_local_e;
  logic        [ LANE_GROUP_IDX_W-1:0] c2v_lane_group_idx_e;
  logic                                c2v_fill_buf_e;
  logic                                c2v_iter_zero_e;
  logic        [        ROW_IDX_W-1:0] c2v_h_base_row_idx_e;
  logic                                comp_read_pair_sel_e;
  logic                                c2v_phase_a;
  logic        [       TILE_IDX_W-1:0] c2v_tile_idx_a;
  logic        [       DIAG_IDX_W-1:0] c2v_diag_idx_local_a;
  logic                                c2v_fill_buf_a;
  logic                                c2v_iter_zero_a;
  logic                                comp_read_pair_sel_a;

  logic                                c2v_valid[0:L-1];
  logic        [            COL_W-1:0] c2v_col_idx[0:L-1];
  logic        [    DIAG_GLOBAL_W-1:0] c2v_diag_idx_global[0:L-1];
  logic        [       LANE_IDX_W-1:0] c2v_row_bank[0:L-1];
  logic        [      ROW_BANK_AW-1:0] c2v_row_addr[0:L-1];
  logic        [       TILE_OFF_W-1:0] c2v_tile_offset[0:L-1];
  logic                                c2v_valid_r[0:L-1];
  logic        [            COL_W-1:0] c2v_col_idx_r[0:L-1];
  logic        [    DIAG_GLOBAL_W-1:0] c2v_diag_idx_global_r[0:L-1];
  logic        [      ROW_BANK_AW-1:0] c2v_row_addr_r[0:L-1];
  logic        [       TILE_OFF_W-1:0] c2v_tile_offset_r[0:L-1];
  logic        [       TILE_IDX_W-1:0] c2v_tile_idx_r;
  logic        [       DIAG_IDX_W-1:0] c2v_diag_idx_local_r;
  logic                                c2v_fill_buf_r;
  logic                                c2v_iter_zero_r;
  logic                                comp_read_pair_sel_r;
  logic                                c2v_valid_q[0:L-1];
  logic        [    DIAG_GLOBAL_W-1:0] c2v_diag_idx_global_q[0:L-1];
  logic        [       TILE_OFF_W-1:0] c2v_tile_offset_q[0:L-1];
  logic signed [            ACC_W-1:0] old_c2v_sum_q[0:L-1];
  logic                                c2v_syndrome_q[0:L-1];
  logic        [       DIAG_IDX_W-1:0] c2v_diag_idx_local_q;
  logic                                c2v_fill_buf_q;
  logic                                c2v_iter_zero_q;
  logic                                c2v_valid_s[0:L-1];
  logic        [    DIAG_GLOBAL_W-1:0] c2v_diag_idx_global_s[0:L-1];
  logic        [       TILE_OFF_W-1:0] c2v_tile_offset_s[0:L-1];
  logic signed [            ACC_W-1:0] old_c2v_sum_s[0:L-1];
  logic        [       COMP_C2V_W-1:0] c2v_comp_s[0:L-1];
  logic                                c2v_syndrome_s[0:L-1];
  logic        [       DIAG_IDX_W-1:0] c2v_diag_idx_local_s;
  logic                                c2v_fill_buf_s;
  logic                                c2v_iter_zero_s;
  logic                                c2v_valid_c[0:L-1];
  logic        [    DIAG_GLOBAL_W-1:0] c2v_diag_idx_global_c[0:L-1];
  logic        [       TILE_OFF_W-1:0] c2v_tile_offset_c[0:L-1];
  logic signed [            ACC_W-1:0] old_c2v_sum_c[0:L-1];
  logic        [       COMP_C2V_W-1:0] c2v_comp_c[0:L-1];
  logic                                c2v_sign_c[0:L-1];
  logic                                c2v_syndrome_c[0:L-1];
  logic        [       DIAG_IDX_W-1:0] c2v_diag_idx_local_c;
  logic                                c2v_fill_buf_c;
  logic                                c2v_iter_zero_c;
  logic                                c2v_valid_p[0:L-1];
  logic        [       TILE_OFF_W-1:0] c2v_tile_offset_p[0:L-1];
  logic        [       DIAG_IDX_W-1:0] c2v_diag_idx_local_p;
  logic                                c2v_fill_buf_p;
  logic signed [            MSG_W-1:0] c2v_tc_p[0:L-1];
  logic signed [            ACC_W-1:0] old_c2v_sum_p[0:L-1];
  logic signed [            ACC_W-1:0] c2v_tc_ext_p[0:L-1];
  logic signed [            ACC_W-1:0] updated_c2v_sum_p[0:L-1];
  logic                                c2v_write_valid[0:L-1];
  logic        [       TILE_OFF_W-1:0] c2v_write_tile_offset[0:L-1];
  logic        [       DIAG_IDX_W-1:0] c2v_write_diag_idx_local;
  logic                                c2v_write_fill_buf;
  logic signed [            MSG_W-1:0] c2v_write_tc[0:L-1];
  logic signed [            ACC_W-1:0] updated_c2v_sum[0:L-1];

  logic                                v2c_phase_h;
  logic        [        H_BLOCK_W-1:0] v2c_h_block_idx_h;
  logic        [       TILE_IDX_W-1:0] v2c_tile_idx_h;
  logic        [       DIAG_IDX_W-1:0] v2c_diag_idx_local_h;
  logic        [ LANE_GROUP_IDX_W-1:0] v2c_lane_group_idx_h;
  logic                                v2c_active_buf_h;
  logic                                v2c_final_iter_h;
  logic                                comp_write_pair_sel_h;
  logic                                v2c_phase_e;
  logic        [        H_BLOCK_W-1:0] v2c_h_block_idx_e;
  logic        [       TILE_IDX_W-1:0] v2c_tile_idx_e;
  logic        [       DIAG_IDX_W-1:0] v2c_diag_idx_local_e;
  logic        [ LANE_GROUP_IDX_W-1:0] v2c_lane_group_idx_e;
  logic                                v2c_active_buf_e;
  logic                                v2c_final_iter_e;
  logic        [        ROW_IDX_W-1:0] v2c_h_base_row_idx_e;
  logic                                comp_write_pair_sel_e;
  logic                                v2c_phase_a;
  logic        [       TILE_IDX_W-1:0] v2c_tile_idx_a;
  logic        [       DIAG_IDX_W-1:0] v2c_diag_idx_local_a;
  logic        [ LANE_GROUP_IDX_W-1:0] v2c_lane_group_idx_a;
  logic                                v2c_active_buf_a;
  logic                                v2c_final_iter_a;
  logic                                comp_write_pair_sel_a;

  logic                                v2c_valid[0:L-1];
  logic        [    DIAG_GLOBAL_W-1:0] v2c_diag_idx_global_base;
  logic        [            COL_W-1:0] v2c_col_idx[0:L-1];
  logic        [    DIAG_GLOBAL_W-1:0] v2c_diag_idx_global[0:L-1];
  logic        [       LANE_IDX_W-1:0] v2c_row_bank[0:L-1];
  logic        [      ROW_BANK_AW-1:0] v2c_row_addr[0:L-1];
  logic        [       TILE_OFF_W-1:0] v2c_tile_offset[0:L-1];
  logic                                v2c_valid_r[0:L-1];
  logic        [            COL_W-1:0] v2c_col_idx_r[0:L-1];
  logic        [    DIAG_GLOBAL_W-1:0] v2c_diag_idx_global_r[0:L-1];
  logic        [      ROW_BANK_AW-1:0] v2c_row_addr_r[0:L-1];
  logic        [       TILE_OFF_W-1:0] v2c_tile_offset_r[0:L-1];
  logic                                v2c_phase_r;
  logic        [       TILE_IDX_W-1:0] v2c_tile_idx_r;
  logic        [    DIAG_GLOBAL_W-1:0] v2c_diag_idx_global_base_r;
  logic        [       DIAG_IDX_W-1:0] v2c_diag_idx_local_r;
  logic        [ LANE_GROUP_IDX_W-1:0] v2c_lane_group_idx_r;
  logic                                v2c_active_buf_r;
  logic                                v2c_final_iter_r;
  logic                                comp_write_pair_sel_r;
  logic                                v2c_valid_q[0:L-1];
  logic        [            COL_W-1:0] v2c_col_idx_q[0:L-1];
  logic        [    DIAG_GLOBAL_W-1:0] v2c_diag_idx_global_q[0:L-1];
  logic        [      ROW_BANK_AW-1:0] v2c_row_addr_q[0:L-1];
  logic        [       TILE_OFF_W-1:0] v2c_tile_offset_q[0:L-1];
  logic signed [            ACC_W-1:0] vnu_c2v_sum_q[0:L-1];
  logic                                v2c_phase_q;
  logic        [       TILE_IDX_W-1:0] v2c_tile_idx_q;
  logic        [    DIAG_GLOBAL_W-1:0] v2c_diag_idx_global_base_q;
  logic        [       DIAG_IDX_W-1:0] v2c_diag_idx_local_q;
  logic        [ LANE_GROUP_IDX_W-1:0] v2c_lane_group_idx_q;
  logic                                v2c_final_iter_q;
  logic                                v2c_write_pair_sel_q;
  logic                                v2c_phase_s;
  logic        [       TILE_IDX_W-1:0] v2c_tile_idx_s;
  logic        [    DIAG_GLOBAL_W-1:0] v2c_diag_idx_global_base_s;
  logic        [       DIAG_IDX_W-1:0] v2c_diag_idx_local_s;
  logic        [ LANE_GROUP_IDX_W-1:0] v2c_lane_group_idx_s;
  logic                                v2c_write_pair_sel_s;
  logic                                decision_we_s[0:L-1];
  logic                                v2c_valid_s[0:L-1];
  logic        [            COL_W-1:0] v2c_col_idx_s[0:L-1];
  logic        [    DIAG_GLOBAL_W-1:0] v2c_diag_idx_global_s[0:L-1];
  logic        [      ROW_BANK_AW-1:0] v2c_row_addr_s[0:L-1];
  logic        [       TILE_OFF_W-1:0] v2c_tile_offset_s[0:L-1];
  logic        [       COMP_C2V_W-1:0] v2c_comp_s[0:L-1];
  logic                                v2c_phase_c;
  logic        [       TILE_IDX_W-1:0] v2c_tile_idx_c;
  logic        [    DIAG_GLOBAL_W-1:0] v2c_diag_idx_global_base_c;
  logic        [       DIAG_IDX_W-1:0] v2c_diag_idx_local_c;
  logic        [ LANE_GROUP_IDX_W-1:0] v2c_lane_group_idx_c;
  logic                                v2c_write_pair_sel_c;
  logic                                v2c_valid_c[0:L-1];
  logic        [            COL_W-1:0] v2c_col_idx_c[0:L-1];
  logic        [    DIAG_GLOBAL_W-1:0] v2c_diag_idx_global_c[0:L-1];
  logic        [      ROW_BANK_AW-1:0] v2c_row_addr_c[0:L-1];
  logic        [       TILE_OFF_W-1:0] v2c_tile_offset_c[0:L-1];
  logic        [       COMP_C2V_W-1:0] v2c_comp_c[0:L-1];
  logic        [            MSG_W-1:0] v2c_msg_c[0:L-1];
  logic                                decision_we_c[0:L-1];
  logic                                posterior_sign_c[0:L-1];
  logic                                v2c_write_phase_p;
  logic        [       TILE_IDX_W-1:0] v2c_write_tile_idx_p;
  logic        [    DIAG_GLOBAL_W-1:0] v2c_write_diag_idx_global_base_p;
  logic        [ LANE_GROUP_IDX_W-1:0] v2c_write_lane_group_idx_p;
  logic                                v2c_write_pair_sel_p;
  logic                                v2c_valid_p[0:L-1];
  logic        [            COL_W-1:0] v2c_col_idx_p[0:L-1];
  logic        [      ROW_BANK_AW-1:0] v2c_row_addr_p[0:L-1];
  logic        [       TILE_OFF_W-1:0] v2c_tile_offset_p[0:L-1];
  logic        [       COMP_C2V_W-1:0] v2c_comp_p[0:L-1];
  logic                                v2c_sign_p[0:L-1];
  logic                                decision_we_p[0:L-1];
  logic                                posterior_sign_p[0:L-1];
  logic                                v2c_bypass_pair_sel_b;
  logic                                v2c_bypass_valid_b[0:L-1];
  logic        [      ROW_BANK_AW-1:0] v2c_bypass_row_addr_b[0:L-1];
  logic        [       COMP_C2V_W-1:0] v2c_bypass_comp_b[0:L-1];
  logic                                ksign_scan_phase_h;
  logic        [        H_BLOCK_W-1:0] ksign_scan_h_block_idx_h;
  logic        [       TILE_IDX_W-1:0] ksign_scan_tile_idx_h;
  logic        [       DIAG_IDX_W-1:0] ksign_scan_diag_idx_local_h;
  logic        [ LANE_GROUP_IDX_W-1:0] ksign_scan_lane_group_idx_h;
  logic                                ksign_scan_phase_e;
  logic        [        H_BLOCK_W-1:0] ksign_scan_h_block_idx_e;
  logic        [       TILE_IDX_W-1:0] ksign_scan_tile_idx_e;
  logic        [       DIAG_IDX_W-1:0] ksign_scan_diag_idx_local_e;
  logic        [ LANE_GROUP_IDX_W-1:0] ksign_scan_lane_group_idx_e;
  logic        [        ROW_IDX_W-1:0] ksign_scan_h_base_row_idx_e;
  logic        [       DIAG_IDX_W-1:0] ksign_scan_diag_idx_local_a;
  logic                                ksign_scan_valid[0:L-1];
  logic        [            COL_W-1:0] ksign_scan_col_idx[0:L-1];
  logic        [      ROW_BANK_AW-1:0] ksign_scan_row_addr[0:L-1];
  logic        [       TILE_OFF_W-1:0] ksign_scan_tile_offset[0:L-1];
  logic        [      ROW_BANK_AW-1:0] ksign_scan_row_addr_r[0:L-1];
  logic                                ksign_delta_flip_valid[0:L-1];
  logic                                ksign_delta_read_mem[0:L-1];
  logic                                ksign_delta_s[0:L-1];
  logic                                ksign_delta_c[0:L-1];
  logic                                comp_flip_valid[0:L-1];
  logic        [      ROW_BANK_AW-1:0] comp_flip_row_addr[0:L-1];

  logic                                syndrome_rdata[0:L-1];
  logic                                syndrome_loaded;
  logic                                syndrome_write_enable;
  logic        [        ROW_IDX_W-1:0] syndrome_expected_addr;
  logic                                comp_read_pair_sel;
  logic                                comp_write_pair_sel;
  logic        [       COMP_C2V_W-1:0] c2v_comp_mem[0:L-1];
  logic        [       COMP_C2V_W-1:0] v2c_comp_mem[0:L-1];
  logic        [       COMP_C2V_W-1:0] v2c_comp_eff[0:L-1];
  logic                                c2v_sign_mem[0:L-1];
  logic                                c2v_ksign_sign_mem[0:L-1];
  logic                                c2v_ksign_base_sign_mem[0:L-1];
  logic                                c2v_ksign_sign_q[0:L-1];
  logic                                ksign_read_valid[0:L-1];
  logic        [            COL_W-1:0] ksign_read_col_idx[0:L-1];
  logic        [       LANE_IDX_W-1:0] external_read_lane1_offset_c;
  logic        [       LANE_IDX_W-1:0] external_read_lane1_offset_q;
  logic        [       DIAG_IDX_W-1:0] ksign_read_diag_idx_local;
  logic                                ksign_commit_valid[0:L-1];
  logic        [            COL_W-1:0] ksign_commit_col_idx[0:L-1];
  logic        [  K_SIGN_RECORD_W-1:0] ksign_commit_record[0:L-1];
  logic                                v2c_sign_wdata[0:L-1];
  logic                                v2c_ksign_base_sign[0:L-1];
  logic signed [            ACC_W-1:0] old_c2v_sum[0:L-1];
  logic signed [            ACC_W-1:0] vnu_c2v_sum[0:L-1];
  logic signed [            ACC_W-1:0] vnu_c2v_edge[0:L-1];
  logic signed [            MSG_W-1:0] vnu_c2v_edge_narrow[0:L-1];
  logic signed [            ACC_W-1:0] c2v_tc_ext[0:L-1];
  logic signed [            ACC_W-1:0] v2c_posterior_next[0:L-1];
  logic signed [            ACC_W-1:0] v2c_tc_next[0:L-1];
  logic        [            MSG_W-1:0] v2c_msg_next[0:L-1];
  logic        [       COMP_C2V_W-1:0] v2c_comp_next[0:L-1];
  logic        [       COMP_C2V_W-1:0] c2v_cnu_b_comp[0:L-1];
  logic        [       COMP_C2V_W-1:0] first_iter_c2v_comp;
  logic                                c2v_cnu_b_sign[0:L-1];
  logic                                c2v_cnu_b_syndrome[0:L-1];
  logic        [            MSG_W-1:0] c2v_msg[0:L-1];
  logic signed [            MSG_W-1:0] c2v_tc[0:L-1];
  logic        [       COMP_C2V_W-1:0] v2c_cnu_a_comp_in[0:L-1];
  logic        [       COMP_C2V_W-1:0] v2c_cnu_a_comp_out[0:L-1];
  logic        [            MSG_W-1:0] v2c_cnu_a_msg[0:L-1];
  logic                                v2c_cnu_a_sign[0:L-1];
  logic                                decision_we[0:L-1];
  logic                                posterior_sign[0:L-1];
  logic                                ctrl_done;
  logic                                ctrl_done_r;
  logic                                ctrl_done_q;
  logic                                ctrl_done_s;
  logic                                ctrl_done_p;
  logic                                ctrl_done_out;
  logic                                ctrl_done_final;

  assign param_level_in = PROFILE_RUNTIME_SELECT ? i_param_level : PROFILE_DEFAULT;
  assign profile_config_level = profile_locked ? param_level : param_level_in;

  assign decode_idle = (state == DEC_WAIT_START) || ((state == DEC_DONE) && ctrl_done_final);
  assign h_load_write_enable = i_h_we && decode_idle && !o_h_loaded && !o_h_error;
  assign syndrome_write_enable = i_syndrome_we && decode_idle && !syndrome_loaded &&
      (CFG_R_W'(i_syndrome_addr) < cfg_r) && (i_syndrome_addr == syndrome_expected_addr);
  assign decode_start = i_start && decode_idle && o_h_loaded && !o_h_error && syndrome_loaded;
  assign o_done = ctrl_done_final;

  reset_sync u_reset_sync (
      .i_clk  (i_clk),
      .i_rst_n(i_rst_n),
      .o_rst_n(rst_n_sync)
  );

  decoder_profile_config u_decoder_profile_config (
      .i_param_level(profile_config_level),
      .o_r(cfg_r),
      .o_w(cfg_w),
      .o_tile_count(cfg_tile_count),
      .o_row_seg_size(cfg_row_seg_size),
      .o_c_val(cfg_c_val),
      .o_alpha_shift_0(cfg_alpha_shift_0),
      .o_alpha_shift_1(cfg_alpha_shift_1)
  );

  generate
    for (genvar lane_idx = 0; lane_idx < L; lane_idx++) begin : g_lane_cnu
      cnu_b u_cnu_b (
          .i_c2v_comp       (c2v_cnu_b_comp[lane_idx]),
          .i_v2c_sign       (c2v_cnu_b_sign[lane_idx]),
          .i_syndrome_bit   (c2v_cnu_b_syndrome[lane_idx]),
          .i_diag_idx_global(c2v_diag_idx_global_c[lane_idx]),
          .o_c2v_msg        (c2v_msg[lane_idx])
      );

      msg_signmag_to_tc #(
          .D           (D),
          .MSG_W       (MSG_W),
          .MSG_MAG_LSB (MSG_MAG_LSB),
          .MSG_SIGN_BIT(MSG_SIGN_BIT)
      ) u_c2v_msg_to_tc (
          .i_msg(c2v_msg[lane_idx]),
          .o_tc (c2v_tc[lane_idx])
      );

      msg_tc_to_signmag_sat #(
          .W       (W),
          .D       (D),
          .MSG_W   (MSG_W),
          .VNU_TC_W(ACC_W),
          .MAG_MAX (MAG_MAX)
      ) u_v2c_tc_to_msg (
          .i_tc (v2c_tc_next[lane_idx]),
          .o_msg(v2c_msg_next[lane_idx])
      );

      assign vnu_c2v_edge[lane_idx] = ACC_W'($signed(vnu_c2v_edge_narrow[lane_idx]));

      cnu_a u_cnu_a (
          .i_v2c_msg        (v2c_cnu_a_msg[lane_idx]),
          .i_diag_idx_global(v2c_diag_idx_global_c[lane_idx]),
          .i_c2v_comp       (v2c_cnu_a_comp_in[lane_idx]),
          .o_c2v_comp       (v2c_cnu_a_comp_out[lane_idx]),
          .o_sign           (v2c_cnu_a_sign[lane_idx])
      );
    end
  endgenerate

  always_comb begin
    first_iter_c2v_comp = {1'b0, DIAG_GLOBAL_W'(0), D'(cfg_c_val), D'(cfg_c_val)};
    ksign_read_diag_idx_local = c2v_diag_idx_local_r;
    external_read_lane1_offset_c = LANE_IDX_W'(i_e_read_col_idx_1) - LANE_IDX_W'(i_e_read_col_idx);

    for (int lane_idx = 0; lane_idx < L; lane_idx++) begin
      c2v_valid[lane_idx] = c2v_corr_valid[lane_idx] && c2v_phase_a;
      c2v_col_idx[lane_idx] = c2v_corr_col_idx[lane_idx];
      c2v_diag_idx_global[lane_idx] = c2v_corr_diag_idx_global[lane_idx];
      c2v_row_bank[lane_idx] = c2v_corr_row_bank[lane_idx];
      c2v_row_addr[lane_idx] = c2v_corr_row_addr[lane_idx];
      c2v_tile_offset[lane_idx] = c2v_corr_tile_offset[lane_idx];
      ksign_read_valid[lane_idx] = c2v_valid_r[lane_idx];
      ksign_read_col_idx[lane_idx] = c2v_col_idx_r[lane_idx];
      // The final posterior sign is the base-sign field of the committed
      // global K-sign record. Once decoding is complete, the C2V bank read
      // ports serve the external decision interface. Lane 0 anchors the bank
      // rotation and the optional second address occupies its bank offset.
      if (K_SIGN_ENABLE && ctrl_done_final && (lane_idx == 0)) begin
        ksign_read_valid[lane_idx]   = 1'b1;
        ksign_read_col_idx[lane_idx] = i_e_read_col_idx;
      end
      if (K_SIGN_ENABLE && ctrl_done_final && i_e_read_valid_1 &&
          (LANE_IDX_W'(lane_idx) == external_read_lane1_offset_c)) begin
        ksign_read_valid[lane_idx]   = 1'b1;
        ksign_read_col_idx[lane_idx] = i_e_read_col_idx_1;
      end
      c2v_tc_ext[lane_idx] = '0;
      v2c_comp_next[lane_idx] = COMP_C2V_INIT;
      v2c_sign_wdata[lane_idx] = v2c_cnu_a_sign[lane_idx];
      v2c_ksign_base_sign[lane_idx] = posterior_sign_c[lane_idx];
      v2c_cnu_a_msg[lane_idx] = v2c_msg_c[lane_idx];
      if (K_SIGN_ENABLE) begin
        v2c_cnu_a_msg[lane_idx][MSG_SIGN_BIT] = posterior_sign_c[lane_idx];
      end
      decision_we[lane_idx] = v2c_valid_q[lane_idx] && v2c_final_iter_q && (v2c_diag_idx_local_q == '0);
      posterior_sign[lane_idx] = v2c_posterior_next[lane_idx][ACC_W-1];
      c2v_cnu_b_comp[lane_idx] = c2v_iter_zero_c ? first_iter_c2v_comp : c2v_comp_c[lane_idx];
      if (K_SIGN_ENABLE && !c2v_iter_zero_c) begin
        c2v_cnu_b_comp[lane_idx][COMP_C2V_SIGN_XOR_BIT] =
            c2v_comp_c[lane_idx][COMP_C2V_SIGN_XOR_BIT] ^ ksign_delta_c[lane_idx];
      end
      c2v_cnu_b_sign[lane_idx] = c2v_iter_zero_c ? 1'b0 : c2v_sign_c[lane_idx];
      c2v_cnu_b_syndrome[lane_idx] = c2v_syndrome_c[lane_idx];
      v2c_cnu_a_comp_in[lane_idx] = v2c_valid_c[lane_idx] ? v2c_comp_c[lane_idx] : COMP_C2V_INIT;
      if (v2c_valid_c[lane_idx]) begin
        v2c_comp_next[lane_idx] = v2c_cnu_a_comp_out[lane_idx];
      end

      v2c_comp_eff[lane_idx] = v2c_comp_mem[lane_idx];
      if (v2c_valid_q[lane_idx] && v2c_valid_c[lane_idx] &&
          (v2c_write_pair_sel_c == v2c_write_pair_sel_q) &&
          (v2c_row_addr_c[lane_idx] == v2c_row_addr_q[lane_idx])) begin
        v2c_comp_eff[lane_idx] = v2c_comp_next[lane_idx];
      end else if (v2c_valid_q[lane_idx] && v2c_valid_p[lane_idx] &&
                   (v2c_write_pair_sel_p == v2c_write_pair_sel_q) &&
                   (v2c_row_addr_p[lane_idx] == v2c_row_addr_q[lane_idx])) begin
        v2c_comp_eff[lane_idx] = v2c_comp_p[lane_idx];
      end else if (v2c_valid_q[lane_idx] && v2c_bypass_valid_b[lane_idx] &&
          (v2c_bypass_pair_sel_b == v2c_write_pair_sel_q) &&
          (v2c_bypass_row_addr_b[lane_idx] == v2c_row_addr_q[lane_idx])) begin
        v2c_comp_eff[lane_idx] = v2c_bypass_comp_b[lane_idx];
      end

      if (c2v_valid_c[lane_idx]) begin
        c2v_tc_ext[lane_idx] = ACC_W'($signed(c2v_tc[lane_idx]));
      end

      updated_c2v_sum_p[lane_idx] = old_c2v_sum_p[lane_idx] + c2v_tc_ext_p[lane_idx];
      if (C2V_WRITE_PIPELINE) begin
        c2v_write_valid[lane_idx] = c2v_valid_p[lane_idx];
        c2v_write_tile_offset[lane_idx] = c2v_tile_offset_p[lane_idx];
        c2v_write_tc[lane_idx] = c2v_tc_p[lane_idx];
        updated_c2v_sum[lane_idx] = updated_c2v_sum_p[lane_idx];
      end else begin
        c2v_write_valid[lane_idx] = c2v_valid_c[lane_idx];
        c2v_write_tile_offset[lane_idx] = c2v_tile_offset_c[lane_idx];
        c2v_write_tc[lane_idx] = c2v_tc[lane_idx];
        updated_c2v_sum[lane_idx] =
            ((c2v_diag_idx_local_c == '0) ? '0 : old_c2v_sum_c[lane_idx]) + c2v_tc_ext[lane_idx];
      end

      comp_flip_valid[lane_idx] = 1'b0;
      comp_flip_row_addr[lane_idx] = '0;

    end

    if (C2V_WRITE_PIPELINE) begin
      c2v_write_fill_buf = c2v_fill_buf_p;
      c2v_write_diag_idx_local = c2v_diag_idx_local_p;
    end else begin
      c2v_write_fill_buf = c2v_fill_buf_c;
      c2v_write_diag_idx_local = c2v_diag_idx_local_c;
    end
  end

  ram_i u_ram_i (
      .i_clk(i_clk),
      .i_rst_n(rst_n_sync),
      .i_clear(1'b0),
      .i_we(h_load_write_enable),
      .i_h_block_idx(i_h_block_idx),
      .i_diag_idx_local(i_h_diag_idx_local),
      .i_base_row_idx(i_h_base_row_idx),
      .i_c2v_h_block_idx(c2v_h_block_idx),
      .i_c2v_diag_idx_local(active_diag_idx_local),
      .i_v2c_h_block_idx(v2c_h_block_idx),
      .i_v2c_diag_idx_local(active_diag_idx_local),
      .i_corr_h_block_idx(ksign_overlap_h_block_idx),
      .i_corr_diag_idx_local(ksign_overlap_diag_idx_local),
      .i_cfg_r(cfg_r),
      .i_cfg_w(cfg_w),
      .o_c2v_base_row_idx(c2v_h_base_row_idx),
      .o_v2c_base_row_idx(v2c_h_base_row_idx),
      .o_corr_base_row_idx(ksign_h_base_row_idx),
      .o_loaded(o_h_loaded),
      .o_error(o_h_error)
  );

  tile_scheduler u_tile_scheduler (
      .i_clk(i_clk),
      .i_rst_n(rst_n_sync),
      .i_start(decode_start),
      .i_ksign_corr_done(ksign_overlap_done),
      .i_cfg_w(cfg_w),
      .i_cfg_tile_count(cfg_tile_count),
      .i_cfg_row_seg_size(cfg_row_seg_size),
      .o_state(state),
      .o_c2v_valid(c2v_phase_active),
      .o_v2c_valid(v2c_phase_active),
      .o_ksign_corr_valid(unused_ksign_corr_phase_active),
      .o_c2v_tile_linear(unused_c2v_tile_linear),
      .o_v2c_tile_linear(v2c_tile_linear),
      .o_c2v_h_block_idx(c2v_h_block_idx),
      .o_c2v_tile_idx(c2v_tile_idx),
      .o_v2c_h_block_idx(v2c_h_block_idx),
      .o_v2c_tile_idx(v2c_tile_idx),
      .o_diag_idx_local(active_diag_idx_local),
      .o_lane_group_idx(active_lane_group_idx),
      .o_clear_valid(comp_clear_valid),
      .o_clear_addr(comp_clear_addr),
      .o_fill_buf(fill_buf),
      .o_active_buf(active_buf),
      .o_final_iter(final_iter),
      .o_iter_first_cycle(unused_iter_first_cycle),
      .o_iter_last_cycle(iter_last_cycle),
      .o_done(ctrl_done),
      .o_iter_count(o_iter_count)
  );

  edge_addr_gen u_c2v_corr_addr_gen (
      .i_clk(i_clk),
      .i_rst_n(rst_n_sync),
      .i_phase_valid(c2v_phase_e),
      .i_h_block_idx(c2v_h_block_idx_e),
      .i_tile_idx(c2v_tile_idx_e),
      .i_lane_group_idx(c2v_lane_group_idx_e),
      .i_base_row_idx(c2v_h_base_row_idx_e),
      .i_diag_idx_local(c2v_diag_idx_local_e),
      .i_cfg_r(cfg_r),
      .i_cfg_w(cfg_w),
      .o_valid(c2v_corr_valid),
      .o_check_row_idx(unused_c2v_corr_check_row_idx),
      .o_col_idx(c2v_corr_col_idx),
      .o_diag_idx_global_base(unused_c2v_corr_diag_idx_global_base),
      .o_diag_idx_global(c2v_corr_diag_idx_global),
      .o_row_bank(c2v_corr_row_bank),
      .o_row_addr(c2v_corr_row_addr),
      .o_tile_offset(c2v_corr_tile_offset)
  );

  assign ksign_overlap_start = K_SIGN_ENABLE && v2c_phase_active &&
      (v2c_tile_linear == '0) &&
      (active_diag_idx_local == DIAG_IDX_W'(cfg_w - CFG_W_W'(1))) &&
      (active_lane_group_idx == LANE_GROUP_IDX_W'(Q_TILE - 1));

  k_sign_overlap_scheduler u_k_sign_overlap_scheduler (
      .i_clk(i_clk),
      .i_rst_n(rst_n_sync),
      .i_start(ksign_overlap_start),
      .i_cfg_w(cfg_w),
      .i_cfg_tile_count(cfg_tile_count),
      .o_phase_valid(ksign_overlap_phase),
      .o_h_block_idx(ksign_overlap_h_block_idx),
      .o_tile_idx(ksign_overlap_tile_idx),
      .o_diag_idx_local(ksign_overlap_diag_idx_local),
      .o_lane_group_idx(ksign_overlap_lane_group_idx),
      .o_done(ksign_overlap_done)
  );

  edge_addr_gen u_ksign_overlap_addr_gen (
      .i_clk(i_clk),
      .i_rst_n(rst_n_sync),
      .i_phase_valid(ksign_scan_phase_e),
      .i_h_block_idx(ksign_scan_h_block_idx_e),
      .i_tile_idx(ksign_scan_tile_idx_e),
      .i_lane_group_idx(ksign_scan_lane_group_idx_e),
      .i_base_row_idx(ksign_scan_h_base_row_idx_e),
      .i_diag_idx_local(ksign_scan_diag_idx_local_e),
      .i_cfg_r(cfg_r),
      .i_cfg_w(cfg_w),
      .o_valid(ksign_scan_valid),
      .o_check_row_idx(unused_ksign_check_row_idx),
      .o_col_idx(ksign_scan_col_idx),
      .o_diag_idx_global_base(unused_ksign_diag_idx_global_base),
      .o_diag_idx_global(unused_ksign_diag_idx_global),
      .o_row_bank(unused_ksign_row_bank),
      .o_row_addr(ksign_scan_row_addr),
      .o_tile_offset(ksign_scan_tile_offset)
  );

  edge_addr_gen u_v2c_addr_gen (
      .i_clk(i_clk),
      .i_rst_n(rst_n_sync),
      .i_phase_valid(v2c_phase_e),
      .i_h_block_idx(v2c_h_block_idx_e),
      .i_tile_idx(v2c_tile_idx_e),
      .i_lane_group_idx(v2c_lane_group_idx_e),
      .i_base_row_idx(v2c_h_base_row_idx_e),
      .i_diag_idx_local(v2c_diag_idx_local_e),
      .i_cfg_r(cfg_r),
      .i_cfg_w(cfg_w),
      .o_valid(v2c_valid),
      .o_check_row_idx(unused_v2c_check_row_idx),
      .o_col_idx(v2c_col_idx),
      .o_diag_idx_global_base(v2c_diag_idx_global_base),
      .o_diag_idx_global(v2c_diag_idx_global),
      .o_row_bank(v2c_row_bank),
      .o_row_addr(v2c_row_addr),
      .o_tile_offset(v2c_tile_offset)
  );

  ram_m u_ram_m (
      .i_clk(i_clk),
      .i_rst_n(rst_n_sync),
      .i_clear_valid(comp_clear_valid),
      .i_clear_pair_sel(comp_write_pair_sel),
      .i_clear_row_addr(comp_clear_addr),
      .i_c2v_pair_sel(comp_read_pair_sel_r),
      .i_c2v_valid(c2v_valid_r),
      .i_c2v_row_addr(c2v_row_addr_r),
      .o_c2v_comp(c2v_comp_mem),
      .i_v2c_pair_sel(comp_write_pair_sel_r),
      .i_v2c_valid(v2c_valid_r),
      .i_v2c_row_addr(v2c_row_addr_r),
      .o_v2c_comp(v2c_comp_mem),
      .i_v2c_write_pair_sel(v2c_write_pair_sel_p),
      .i_v2c_write_valid(v2c_valid_p),
      .i_v2c_write_row_addr(v2c_row_addr_p),
      .i_v2c_write_data(v2c_comp_p),
      .i_flip_pair_sel(1'b0),
      .i_flip_valid(comp_flip_valid),
      .i_flip_row_addr(comp_flip_row_addr)
  );

  generate
    if (K_SIGN_ENABLE) begin : g_sign_k
      /* verilator lint_off UNUSEDSIGNAL */
      logic [K_SIGN_RECORD_W-1:0] unused_ksign_read_record[0:L-1];
      logic [K_SIGN_RECORD_W-1:0] unused_ksign_corr_record[0:L-1];
      logic                       unused_ksign_read_hit[0:L-1];
      /* verilator lint_on UNUSEDSIGNAL */

      k_sign_selector u_k_sign_selector (
          .i_clk                (i_clk),
          .i_rst_n              (rst_n_sync),
          .i_cfg_w              (cfg_w),
          .i_valid              (v2c_valid_c),
          .i_col_idx            (v2c_col_idx_c),
          .i_tile_offset        (v2c_tile_offset_c),
          .i_diag_idx_local     (v2c_diag_idx_local_c),
          .i_v2c_msg            (v2c_msg_c),
          .i_base_sign          (v2c_ksign_base_sign),
          .o_commit_valid       (ksign_commit_valid),
          .o_commit_col_idx     (ksign_commit_col_idx),
          .o_commit_record      (ksign_commit_record),
          .i_corr_read_valid    (ksign_scan_valid),
          .i_corr_col_idx       (ksign_scan_col_idx),
          .i_corr_tile_offset   (ksign_scan_tile_offset),
          .i_corr_diag_idx_local(ksign_scan_diag_idx_local_a),
          .o_corr_read_record   (unused_ksign_corr_record),
          .o_corr_read_hit      (ksign_delta_flip_valid)
      );

      ram_k_global u_ram_k_global (
          .i_clk                (i_clk),
          .i_rst_n              (rst_n_sync),
          .i_read_valid         (ksign_read_valid),
          .i_read_col_idx       (ksign_read_col_idx),
          .i_read_diag_idx_local(ksign_read_diag_idx_local),
          .o_read_record        (unused_ksign_read_record),
          .o_read_sign          (c2v_ksign_sign_mem),
          .o_read_hit           (unused_ksign_read_hit),
          .o_read_base_sign     (c2v_ksign_base_sign_mem),
          .i_write_valid        (ksign_commit_valid),
          .i_write_col_idx      (ksign_commit_col_idx),
          .i_write_record       (ksign_commit_record)
      );

      ram_sign_delta u_ram_sign_delta (
          .i_clk(i_clk),
          .i_rst_n(rst_n_sync),
          .i_clear_valid(comp_clear_valid),
          .i_clear_pair_sel(comp_write_pair_sel),
          .i_clear_row_addr(comp_clear_addr),
          .i_read_pair_sel(comp_read_pair_sel_r),
          .i_read_valid(c2v_valid_r),
          .i_read_row_addr(c2v_row_addr_r),
          .o_read_delta(ksign_delta_read_mem),
          .i_flip_pair_sel(comp_write_pair_sel),
          .i_flip_valid(ksign_delta_flip_valid),
          .i_flip_row_addr(ksign_scan_row_addr_r)
      );

      for (genvar lane_idx = 0; lane_idx < L; lane_idx++) begin : g_sign_reconstruct
        assign c2v_sign_mem[lane_idx] = 1'b0;
      end
    end else begin : g_sign_full
      ram_s u_ram_s (
          .i_clk(i_clk),
          .i_rst_n(rst_n_sync),
          .i_c2v_valid(c2v_valid_r),
          .i_c2v_tile_idx(c2v_tile_idx_r),
          .i_c2v_tile_offset(c2v_tile_offset_r),
          .i_c2v_diag_idx_global(c2v_diag_idx_global_r),
          .o_c2v_sign(c2v_sign_mem),
          .i_v2c_phase_valid(v2c_write_phase_p),
          .i_v2c_tile_idx(v2c_write_tile_idx_p),
          .i_v2c_lane_group_idx(v2c_write_lane_group_idx_p),
          .i_v2c_diag_idx_global(v2c_write_diag_idx_global_base_p),
          .i_v2c_write_valid(v2c_valid_p),
          .i_v2c_tile_offset(v2c_tile_offset_p),
          .i_v2c_sign(v2c_sign_p)
      );

      for (genvar lane_idx = 0; lane_idx < L; lane_idx++) begin : g_ksign_const
        assign c2v_ksign_sign_mem[lane_idx] = 1'b0;
        assign c2v_ksign_base_sign_mem[lane_idx] = 1'b0;
        assign ksign_commit_valid[lane_idx] = 1'b0;
        assign ksign_commit_col_idx[lane_idx] = '0;
        assign ksign_commit_record[lane_idx] = '0;
        assign ksign_delta_flip_valid[lane_idx] = 1'b0;
        assign ksign_delta_read_mem[lane_idx] = 1'b0;
      end
    end
  endgenerate

  ram_accum u_ram_accum (
      .i_clk(i_clk),
      .i_c2v_read_buf(c2v_fill_buf_r),
      .i_c2v_read_valid(c2v_valid_r),
      .i_c2v_read_tile_offset(c2v_tile_offset_r),
      .o_old_c2v_sum(old_c2v_sum),
      .i_c2v_write_buf(c2v_write_fill_buf),
      .i_c2v_write_valid(c2v_write_valid),
      .i_c2v_write_tile_offset(c2v_write_tile_offset),
      .i_updated_c2v_sum(updated_c2v_sum),
      .i_active_buf(v2c_active_buf_r),
      .i_v2c_valid(v2c_valid_r),
      .i_v2c_tile_offset(v2c_tile_offset_r),
      .o_c2v_sum(vnu_c2v_sum)
  );

  ram_t u_ram_t (
      .i_clk(i_clk),
      .i_rst_n(rst_n_sync),
      .i_fill_buf(c2v_write_fill_buf),
      .i_c2v_write_valid(c2v_write_valid),
      .i_c2v_write_diag_idx_local(c2v_write_diag_idx_local),
      .i_c2v_write_tile_offset(c2v_write_tile_offset),
      .i_c2v_tc(c2v_write_tc),
      .i_active_buf(v2c_active_buf_r),
      .i_v2c_valid(v2c_valid_r),
      .i_v2c_diag_idx_local(v2c_diag_idx_local_r),
      .i_v2c_tile_offset(v2c_tile_offset_r),
      .o_c2v_edge(vnu_c2v_edge_narrow)
  );

  vnu u_vnu (
      .i_clk(i_clk),
      .i_rst_n(rst_n_sync),
      .i_valid(v2c_valid_q),
      .i_c2v_sum(vnu_c2v_sum_q),
      .i_c2v_edge(vnu_c2v_edge),
      .i_cfg_c_val(cfg_c_val),
      .i_cfg_alpha_shift_0(cfg_alpha_shift_0),
      .i_cfg_alpha_shift_1(cfg_alpha_shift_1),
      .o_posterior(v2c_posterior_next),
      .o_v2c_tc(v2c_tc_next)
  );

  generate
    if (K_SIGN_ENABLE) begin : g_ksign_decision_read
      assign o_e_rdata   = c2v_ksign_base_sign_mem[0];
      assign o_e_rdata_1 = c2v_ksign_base_sign_mem[external_read_lane1_offset_q];
    end else begin : g_full_sign_decision_read
      ram_decision u_ram_decision (
          .i_clk(i_clk),
          .i_rst_n(rst_n_sync),
          .i_we(decision_we_p),
          .i_write_col_idx(v2c_col_idx_p),
          .i_wdata(posterior_sign_p),
          .i_read_col_idx(i_e_read_col_idx),
          .i_read_col_idx_1(i_e_read_col_idx_1),
          .i_read_valid_1(i_e_read_valid_1),
          .o_rdata(o_e_rdata),
          .o_rdata_1(o_e_rdata_1)
      );
    end
  endgenerate

  always_ff @(posedge i_clk or negedge rst_n_sync) begin
    if (!rst_n_sync) begin
      external_read_lane1_offset_q <= '0;
    end else begin
      external_read_lane1_offset_q <= external_read_lane1_offset_c;
    end
  end

`ifndef SYNTHESIS
  always_ff @(posedge i_clk) begin
    if (rst_n_sync && ctrl_done_final && i_e_read_valid_1 &&
        (external_read_lane1_offset_c == '0)) begin
      $fatal(1, "decoder_top external decision reads target the same bank");
    end
    if (rst_n_sync && i_h_we && !h_load_write_enable) begin
      $fatal(1, "decoder_top rejected H write outside the initial idle load window");
    end
    if (rst_n_sync && i_syndrome_we && !syndrome_write_enable) begin
      $fatal(1, "decoder_top rejected syndrome write addr=%0d expected=%0d idle=%0b loaded=%0b",
             i_syndrome_addr, syndrome_expected_addr, decode_idle, syndrome_loaded);
    end
    for (int lhs = 0; lhs < L; lhs++) begin
      for (int rhs = lhs + 1; rhs < L; rhs++) begin
        if (c2v_valid[lhs] && c2v_valid[rhs] && (c2v_row_bank[lhs] == c2v_row_bank[rhs])) begin
          $fatal(1, "decoder_top c2v row-bank conflict bank=%0d", c2v_row_bank[lhs]);
        end
        if (v2c_valid[lhs] && v2c_valid[rhs] && (v2c_row_bank[lhs] == v2c_row_bank[rhs])) begin
          $fatal(1, "decoder_top v2c row-bank conflict bank=%0d", v2c_row_bank[lhs]);
        end
      end
    end
  end

`endif

  always_ff @(posedge i_clk or negedge rst_n_sync) begin
    if (!rst_n_sync) begin
      param_level <= PROFILE_DEFAULT;
      profile_locked <= 1'b0;
      c2v_diag_idx_local_q <= '0;
      c2v_fill_buf_q <= 1'b0;
      c2v_iter_zero_q <= 1'b0;
      c2v_diag_idx_local_s <= '0;
      c2v_fill_buf_s <= 1'b0;
      c2v_iter_zero_s <= 1'b0;
      c2v_diag_idx_local_c <= '0;
      c2v_fill_buf_c <= 1'b0;
      c2v_iter_zero_c <= 1'b0;
      c2v_diag_idx_local_p <= '0;
      c2v_fill_buf_p <= 1'b0;
      c2v_phase_h <= 1'b0;
      c2v_h_block_idx_h <= '0;
      c2v_tile_idx_h <= '0;
      c2v_diag_idx_local_h <= '0;
      c2v_lane_group_idx_h <= '0;
      c2v_fill_buf_h <= 1'b0;
      c2v_iter_zero_h <= 1'b0;
      comp_read_pair_sel_h <= 1'b0;
      c2v_phase_e <= 1'b0;
      c2v_h_block_idx_e <= '0;
      c2v_tile_idx_e <= '0;
      c2v_diag_idx_local_e <= '0;
      c2v_lane_group_idx_e <= '0;
      c2v_fill_buf_e <= 1'b0;
      c2v_iter_zero_e <= 1'b0;
      c2v_h_base_row_idx_e <= '0;
      comp_read_pair_sel_e <= 1'b0;
      c2v_phase_a <= 1'b0;
      c2v_tile_idx_a <= '0;
      c2v_diag_idx_local_a <= '0;
      c2v_fill_buf_a <= 1'b0;
      c2v_iter_zero_a <= 1'b0;
      comp_read_pair_sel_a <= 1'b0;
      c2v_diag_idx_local_r <= '0;
      c2v_tile_idx_r <= '0;
      c2v_fill_buf_r <= 1'b0;
      c2v_iter_zero_r <= 1'b0;
      comp_read_pair_sel_r <= 1'b0;
      v2c_diag_idx_local_q <= '0;
      v2c_lane_group_idx_q <= '0;
      v2c_phase_h <= 1'b0;
      v2c_h_block_idx_h <= '0;
      v2c_tile_idx_h <= '0;
      v2c_diag_idx_local_h <= '0;
      v2c_lane_group_idx_h <= '0;
      v2c_active_buf_h <= 1'b0;
      v2c_final_iter_h <= 1'b0;
      comp_write_pair_sel_h <= 1'b0;
      v2c_phase_q <= 1'b0;
      v2c_tile_idx_q <= '0;
      v2c_diag_idx_global_base_q <= '0;
      v2c_final_iter_q <= 1'b0;
      v2c_phase_s <= 1'b0;
      v2c_tile_idx_s <= '0;
      v2c_diag_idx_global_base_s <= '0;
      v2c_diag_idx_local_s <= '0;
      v2c_lane_group_idx_s <= '0;
      v2c_write_pair_sel_s <= 1'b0;
      v2c_phase_c <= 1'b0;
      v2c_tile_idx_c <= '0;
      v2c_diag_idx_global_base_c <= '0;
      v2c_diag_idx_local_c <= '0;
      v2c_lane_group_idx_c <= '0;
      v2c_write_pair_sel_c <= 1'b0;
      v2c_write_phase_p <= 1'b0;
      v2c_write_tile_idx_p <= '0;
      v2c_write_diag_idx_global_base_p <= '0;
      v2c_write_lane_group_idx_p <= '0;
      v2c_write_pair_sel_p <= 1'b0;
      v2c_bypass_pair_sel_b <= 1'b0;
      ksign_scan_phase_h <= 1'b0;
      ksign_scan_h_block_idx_h <= '0;
      ksign_scan_tile_idx_h <= '0;
      ksign_scan_diag_idx_local_h <= '0;
      ksign_scan_lane_group_idx_h <= '0;
      ksign_scan_phase_e <= 1'b0;
      ksign_scan_h_block_idx_e <= '0;
      ksign_scan_tile_idx_e <= '0;
      ksign_scan_diag_idx_local_e <= '0;
      ksign_scan_lane_group_idx_e <= '0;
      ksign_scan_h_base_row_idx_e <= '0;
      ksign_scan_diag_idx_local_a <= '0;
      v2c_phase_e <= 1'b0;
      v2c_h_block_idx_e <= '0;
      v2c_tile_idx_e <= '0;
      v2c_diag_idx_local_e <= '0;
      v2c_lane_group_idx_e <= '0;
      v2c_active_buf_e <= 1'b0;
      v2c_final_iter_e <= 1'b0;
      v2c_h_base_row_idx_e <= '0;
      comp_write_pair_sel_e <= 1'b0;
      v2c_phase_a <= 1'b0;
      v2c_tile_idx_a <= '0;
      v2c_diag_idx_local_a <= '0;
      v2c_lane_group_idx_a <= '0;
      v2c_active_buf_a <= 1'b0;
      v2c_final_iter_a <= 1'b0;
      comp_write_pair_sel_a <= 1'b0;
      v2c_phase_r <= 1'b0;
      v2c_tile_idx_r <= '0;
      v2c_diag_idx_global_base_r <= '0;
      v2c_diag_idx_local_r <= '0;
      v2c_lane_group_idx_r <= '0;
      v2c_active_buf_r <= 1'b0;
      v2c_final_iter_r <= 1'b0;
      comp_write_pair_sel_r <= 1'b0;
      v2c_write_pair_sel_q <= 1'b0;
      ctrl_done_r <= 1'b0;
      ctrl_done_q <= 1'b0;
      ctrl_done_s <= 1'b0;
      ctrl_done_p <= 1'b0;
      ctrl_done_out <= 1'b0;
      ctrl_done_final <= 1'b0;
      for (int lane_idx = 0; lane_idx < L; lane_idx++) begin
        c2v_valid_r[lane_idx] <= 1'b0;
        c2v_col_idx_r[lane_idx] <= '0;
        c2v_diag_idx_global_r[lane_idx] <= '0;
        c2v_row_addr_r[lane_idx] <= '0;
        c2v_tile_offset_r[lane_idx] <= '0;
        c2v_valid_q[lane_idx] <= 1'b0;
        c2v_diag_idx_global_q[lane_idx] <= '0;
        c2v_tile_offset_q[lane_idx] <= '0;
        old_c2v_sum_q[lane_idx] <= '0;
        c2v_syndrome_q[lane_idx] <= 1'b0;
        c2v_valid_s[lane_idx] <= 1'b0;
        c2v_diag_idx_global_s[lane_idx] <= '0;
        c2v_tile_offset_s[lane_idx] <= '0;
        old_c2v_sum_s[lane_idx] <= '0;
        c2v_comp_s[lane_idx] <= COMP_C2V_INIT;
        ksign_delta_s[lane_idx] <= 1'b0;
        ksign_delta_c[lane_idx] <= 1'b0;
        c2v_syndrome_s[lane_idx] <= 1'b0;
        c2v_valid_c[lane_idx] <= 1'b0;
        c2v_diag_idx_global_c[lane_idx] <= '0;
        c2v_tile_offset_c[lane_idx] <= '0;
        old_c2v_sum_c[lane_idx] <= '0;
        c2v_comp_c[lane_idx] <= COMP_C2V_INIT;
        c2v_sign_c[lane_idx] <= 1'b0;
        c2v_syndrome_c[lane_idx] <= 1'b0;
        c2v_valid_p[lane_idx] <= 1'b0;
        c2v_tile_offset_p[lane_idx] <= '0;
        c2v_tc_p[lane_idx] <= '0;
        old_c2v_sum_p[lane_idx] <= '0;
        c2v_tc_ext_p[lane_idx] <= '0;
        c2v_ksign_sign_q[lane_idx] <= 1'b0;
        v2c_valid_r[lane_idx] <= 1'b0;
        v2c_col_idx_r[lane_idx] <= '0;
        v2c_diag_idx_global_r[lane_idx] <= '0;
        v2c_row_addr_r[lane_idx] <= '0;
        v2c_tile_offset_r[lane_idx] <= '0;
        v2c_valid_q[lane_idx] <= 1'b0;
        v2c_col_idx_q[lane_idx] <= '0;
        v2c_diag_idx_global_q[lane_idx] <= '0;
        v2c_row_addr_q[lane_idx] <= '0;
        v2c_tile_offset_q[lane_idx] <= '0;
        vnu_c2v_sum_q[lane_idx] <= '0;
        v2c_valid_s[lane_idx] <= 1'b0;
        v2c_col_idx_s[lane_idx] <= '0;
        v2c_diag_idx_global_s[lane_idx] <= '0;
        v2c_row_addr_s[lane_idx] <= '0;
        v2c_tile_offset_s[lane_idx] <= '0;
        v2c_comp_s[lane_idx] <= COMP_C2V_INIT;
        decision_we_s[lane_idx] <= 1'b0;
        v2c_valid_c[lane_idx] <= 1'b0;
        v2c_col_idx_c[lane_idx] <= '0;
        v2c_diag_idx_global_c[lane_idx] <= '0;
        v2c_row_addr_c[lane_idx] <= '0;
        v2c_tile_offset_c[lane_idx] <= '0;
        v2c_comp_c[lane_idx] <= COMP_C2V_INIT;
        v2c_msg_c[lane_idx] <= '0;
        decision_we_c[lane_idx] <= 1'b0;
        posterior_sign_c[lane_idx] <= 1'b0;
        v2c_valid_p[lane_idx] <= 1'b0;
        v2c_col_idx_p[lane_idx] <= '0;
        v2c_row_addr_p[lane_idx] <= '0;
        v2c_tile_offset_p[lane_idx] <= '0;
        v2c_comp_p[lane_idx] <= COMP_C2V_INIT;
        v2c_sign_p[lane_idx] <= 1'b0;
        decision_we_p[lane_idx] <= 1'b0;
        posterior_sign_p[lane_idx] <= 1'b0;
        v2c_bypass_valid_b[lane_idx] <= 1'b0;
        v2c_bypass_row_addr_b[lane_idx] <= '0;
        v2c_bypass_comp_b[lane_idx] <= COMP_C2V_INIT;
        ksign_scan_row_addr_r[lane_idx] <= '0;
      end
    end else begin
      if (!profile_locked) begin
        param_level <= param_level_in;
        if (h_load_write_enable || syndrome_write_enable) begin
          profile_locked <= 1'b1;
        end
      end

      c2v_phase_h <= c2v_phase_active;
      c2v_h_block_idx_h <= c2v_h_block_idx;
      c2v_tile_idx_h <= c2v_tile_idx;
      c2v_diag_idx_local_h <= active_diag_idx_local;
      c2v_lane_group_idx_h <= active_lane_group_idx;
      c2v_fill_buf_h <= fill_buf;
      c2v_iter_zero_h <= o_iter_count == '0;
      comp_read_pair_sel_h <= comp_read_pair_sel;
      c2v_phase_e <= c2v_phase_h;
      c2v_h_block_idx_e <= c2v_h_block_idx_h;
      c2v_tile_idx_e <= c2v_tile_idx_h;
      c2v_diag_idx_local_e <= c2v_diag_idx_local_h;
      c2v_lane_group_idx_e <= c2v_lane_group_idx_h;
      c2v_fill_buf_e <= c2v_fill_buf_h;
      c2v_iter_zero_e <= c2v_iter_zero_h;
      c2v_h_base_row_idx_e <= c2v_h_base_row_idx;
      comp_read_pair_sel_e <= comp_read_pair_sel_h;
      c2v_phase_a <= c2v_phase_e;
      c2v_tile_idx_a <= c2v_tile_idx_e;
      c2v_diag_idx_local_a <= c2v_diag_idx_local_e;
      c2v_fill_buf_a <= c2v_fill_buf_e;
      c2v_iter_zero_a <= c2v_iter_zero_e;
      comp_read_pair_sel_a <= comp_read_pair_sel_e;
      c2v_diag_idx_local_r <= c2v_diag_idx_local_a;
      c2v_tile_idx_r <= c2v_tile_idx_a;
      c2v_fill_buf_r <= c2v_fill_buf_a;
      c2v_iter_zero_r <= c2v_iter_zero_a;
      comp_read_pair_sel_r <= comp_read_pair_sel_a;
      c2v_diag_idx_local_q <= c2v_diag_idx_local_r;
      c2v_fill_buf_q <= c2v_fill_buf_r;
      c2v_iter_zero_q <= c2v_iter_zero_r;
      c2v_diag_idx_local_s <= c2v_diag_idx_local_q;
      c2v_fill_buf_s <= c2v_fill_buf_q;
      c2v_iter_zero_s <= c2v_iter_zero_q;
      c2v_diag_idx_local_c <= c2v_diag_idx_local_s;
      c2v_fill_buf_c <= c2v_fill_buf_s;
      c2v_iter_zero_c <= c2v_iter_zero_s;
      c2v_diag_idx_local_p <= c2v_diag_idx_local_c;
      c2v_fill_buf_p <= c2v_fill_buf_c;

      v2c_phase_h <= v2c_phase_active;
      v2c_h_block_idx_h <= v2c_h_block_idx;
      v2c_tile_idx_h <= v2c_tile_idx;
      v2c_diag_idx_local_h <= active_diag_idx_local;
      v2c_lane_group_idx_h <= active_lane_group_idx;
      v2c_active_buf_h <= active_buf;
      v2c_final_iter_h <= final_iter;
      comp_write_pair_sel_h <= comp_write_pair_sel;
      v2c_phase_e <= v2c_phase_h;
      v2c_h_block_idx_e <= v2c_h_block_idx_h;
      v2c_tile_idx_e <= v2c_tile_idx_h;
      v2c_diag_idx_local_e <= v2c_diag_idx_local_h;
      v2c_lane_group_idx_e <= v2c_lane_group_idx_h;
      v2c_active_buf_e <= v2c_active_buf_h;
      v2c_final_iter_e <= v2c_final_iter_h;
      v2c_h_base_row_idx_e <= v2c_h_base_row_idx;
      comp_write_pair_sel_e <= comp_write_pair_sel_h;
      v2c_phase_a <= v2c_phase_e;
      v2c_tile_idx_a <= v2c_tile_idx_e;
      v2c_diag_idx_local_a <= v2c_diag_idx_local_e;
      v2c_lane_group_idx_a <= v2c_lane_group_idx_e;
      v2c_active_buf_a <= v2c_active_buf_e;
      v2c_final_iter_a <= v2c_final_iter_e;
      comp_write_pair_sel_a <= comp_write_pair_sel_e;
      v2c_phase_r <= v2c_phase_a;
      v2c_tile_idx_r <= v2c_tile_idx_a;
      v2c_diag_idx_global_base_r <= v2c_diag_idx_global_base;
      v2c_diag_idx_local_r <= v2c_diag_idx_local_a;
      v2c_lane_group_idx_r <= v2c_lane_group_idx_a;
      v2c_active_buf_r <= v2c_active_buf_a;
      v2c_final_iter_r <= v2c_final_iter_a;
      comp_write_pair_sel_r <= comp_write_pair_sel_a;
      v2c_phase_q <= v2c_phase_r;
      v2c_tile_idx_q <= v2c_tile_idx_r;
      v2c_diag_idx_global_base_q <= v2c_diag_idx_global_base_r;
      v2c_diag_idx_local_q <= v2c_diag_idx_local_r;
      v2c_lane_group_idx_q <= v2c_lane_group_idx_r;
      v2c_final_iter_q <= v2c_final_iter_r;
      v2c_write_pair_sel_q <= comp_write_pair_sel_r;
      v2c_phase_s <= v2c_phase_q;
      v2c_tile_idx_s <= v2c_tile_idx_q;
      v2c_diag_idx_global_base_s <= v2c_diag_idx_global_base_q;
      v2c_diag_idx_local_s <= v2c_diag_idx_local_q;
      v2c_lane_group_idx_s <= v2c_lane_group_idx_q;
      v2c_write_pair_sel_s <= v2c_write_pair_sel_q;
      v2c_phase_c <= v2c_phase_s;
      v2c_tile_idx_c <= v2c_tile_idx_s;
      v2c_diag_idx_global_base_c <= v2c_diag_idx_global_base_s;
      v2c_diag_idx_local_c <= v2c_diag_idx_local_s;
      v2c_lane_group_idx_c <= v2c_lane_group_idx_s;
      v2c_write_pair_sel_c <= v2c_write_pair_sel_s;
      v2c_write_phase_p <= v2c_phase_c;
      v2c_write_tile_idx_p <= v2c_tile_idx_c;
      v2c_write_diag_idx_global_base_p <= v2c_diag_idx_global_base_c;
      v2c_write_lane_group_idx_p <= v2c_lane_group_idx_c;
      v2c_write_pair_sel_p <= v2c_write_pair_sel_c;
      v2c_bypass_pair_sel_b <= v2c_write_pair_sel_p;
      ksign_scan_phase_h <= ksign_overlap_phase;
      ksign_scan_h_block_idx_h <= ksign_overlap_h_block_idx;
      ksign_scan_tile_idx_h <= ksign_overlap_tile_idx;
      ksign_scan_diag_idx_local_h <= ksign_overlap_diag_idx_local;
      ksign_scan_lane_group_idx_h <= ksign_overlap_lane_group_idx;
      ksign_scan_phase_e <= ksign_scan_phase_h;
      ksign_scan_h_block_idx_e <= ksign_scan_h_block_idx_h;
      ksign_scan_tile_idx_e <= ksign_scan_tile_idx_h;
      ksign_scan_diag_idx_local_e <= ksign_scan_diag_idx_local_h;
      ksign_scan_lane_group_idx_e <= ksign_scan_lane_group_idx_h;
      ksign_scan_h_base_row_idx_e <= ksign_h_base_row_idx;
      ksign_scan_diag_idx_local_a <= ksign_scan_diag_idx_local_e;
      if (decode_start) begin
        ctrl_done_r <= 1'b0;
        ctrl_done_q <= 1'b0;
        ctrl_done_s <= 1'b0;
        ctrl_done_p <= 1'b0;
        ctrl_done_out <= 1'b0;
        ctrl_done_final <= 1'b0;
      end else begin
        ctrl_done_r <= ctrl_done;
        ctrl_done_q <= ctrl_done_r;
        ctrl_done_s <= ctrl_done_q;
        ctrl_done_p <= ctrl_done_s;
        ctrl_done_out <= ctrl_done_p;
        ctrl_done_final <= ctrl_done_out;
      end
      for (int lane_idx = 0; lane_idx < L; lane_idx++) begin
        c2v_valid_r[lane_idx] <= c2v_valid[lane_idx];
        c2v_col_idx_r[lane_idx] <= c2v_col_idx[lane_idx];
        c2v_diag_idx_global_r[lane_idx] <= c2v_diag_idx_global[lane_idx];
        c2v_row_addr_r[lane_idx] <= c2v_row_addr[lane_idx];
        c2v_tile_offset_r[lane_idx] <= c2v_tile_offset[lane_idx];
        c2v_valid_q[lane_idx] <= c2v_valid_r[lane_idx];
        c2v_diag_idx_global_q[lane_idx] <= c2v_diag_idx_global_r[lane_idx];
        c2v_tile_offset_q[lane_idx] <= c2v_tile_offset_r[lane_idx];
        old_c2v_sum_q[lane_idx] <= old_c2v_sum[lane_idx];
        c2v_syndrome_q[lane_idx] <= syndrome_rdata[lane_idx];
        c2v_valid_s[lane_idx] <= c2v_valid_q[lane_idx];
        c2v_diag_idx_global_s[lane_idx] <= c2v_diag_idx_global_q[lane_idx];
        c2v_tile_offset_s[lane_idx] <= c2v_tile_offset_q[lane_idx];
        old_c2v_sum_s[lane_idx] <= old_c2v_sum_q[lane_idx];
        c2v_comp_s[lane_idx] <= c2v_comp_mem[lane_idx];
        ksign_delta_s[lane_idx] <= ksign_delta_read_mem[lane_idx];
        c2v_syndrome_s[lane_idx] <= c2v_syndrome_q[lane_idx];
        c2v_valid_c[lane_idx] <= c2v_valid_s[lane_idx];
        c2v_diag_idx_global_c[lane_idx] <= c2v_diag_idx_global_s[lane_idx];
        c2v_tile_offset_c[lane_idx] <= c2v_tile_offset_s[lane_idx];
        old_c2v_sum_c[lane_idx] <= old_c2v_sum_s[lane_idx];
        c2v_comp_c[lane_idx] <= c2v_comp_s[lane_idx];
        ksign_delta_c[lane_idx] <= ksign_delta_s[lane_idx];
        c2v_sign_c[lane_idx] <= K_SIGN_ENABLE ? c2v_ksign_sign_q[lane_idx] : c2v_sign_mem[lane_idx];
        c2v_syndrome_c[lane_idx] <= c2v_syndrome_s[lane_idx];
        c2v_valid_p[lane_idx] <= c2v_valid_c[lane_idx];
        c2v_tile_offset_p[lane_idx] <= c2v_tile_offset_c[lane_idx];
        c2v_tc_p[lane_idx] <= c2v_tc[lane_idx];
        old_c2v_sum_p[lane_idx] <= (c2v_diag_idx_local_c == '0) ? '0 : old_c2v_sum_c[lane_idx];
        c2v_tc_ext_p[lane_idx] <= c2v_tc_ext[lane_idx];
        c2v_ksign_sign_q[lane_idx] <= c2v_ksign_sign_mem[lane_idx];
        v2c_valid_r[lane_idx] <= v2c_valid[lane_idx];
        v2c_col_idx_r[lane_idx] <= v2c_col_idx[lane_idx];
        v2c_diag_idx_global_r[lane_idx] <= v2c_diag_idx_global[lane_idx];
        v2c_row_addr_r[lane_idx] <= v2c_row_addr[lane_idx];
        v2c_tile_offset_r[lane_idx] <= v2c_tile_offset[lane_idx];
        v2c_valid_q[lane_idx] <= v2c_valid_r[lane_idx];
        v2c_col_idx_q[lane_idx] <= v2c_col_idx_r[lane_idx];
        v2c_diag_idx_global_q[lane_idx] <= v2c_diag_idx_global_r[lane_idx];
        v2c_row_addr_q[lane_idx] <= v2c_row_addr_r[lane_idx];
        v2c_tile_offset_q[lane_idx] <= v2c_tile_offset_r[lane_idx];
        vnu_c2v_sum_q[lane_idx] <= vnu_c2v_sum[lane_idx];
        v2c_valid_s[lane_idx] <= v2c_valid_q[lane_idx];
        v2c_col_idx_s[lane_idx] <= v2c_col_idx_q[lane_idx];
        v2c_diag_idx_global_s[lane_idx] <= v2c_diag_idx_global_q[lane_idx];
        v2c_row_addr_s[lane_idx] <= v2c_row_addr_q[lane_idx];
        v2c_tile_offset_s[lane_idx] <= v2c_tile_offset_q[lane_idx];
        v2c_comp_s[lane_idx] <= v2c_valid_q[lane_idx] ? v2c_comp_eff[lane_idx] : COMP_C2V_INIT;
        decision_we_s[lane_idx] <= decision_we[lane_idx];
        v2c_valid_c[lane_idx] <= v2c_valid_s[lane_idx];
        v2c_col_idx_c[lane_idx] <= v2c_col_idx_s[lane_idx];
        v2c_diag_idx_global_c[lane_idx] <= v2c_diag_idx_global_s[lane_idx];
        v2c_row_addr_c[lane_idx] <= v2c_row_addr_s[lane_idx];
        v2c_tile_offset_c[lane_idx] <= v2c_tile_offset_s[lane_idx];
        v2c_comp_c[lane_idx] <= v2c_comp_s[lane_idx];
        v2c_msg_c[lane_idx] <= v2c_msg_next[lane_idx];
        decision_we_c[lane_idx] <= decision_we_s[lane_idx];
        posterior_sign_c[lane_idx] <= posterior_sign[lane_idx];
        v2c_valid_p[lane_idx] <= v2c_valid_c[lane_idx];
        v2c_col_idx_p[lane_idx] <= v2c_col_idx_c[lane_idx];
        v2c_row_addr_p[lane_idx] <= v2c_row_addr_c[lane_idx];
        v2c_tile_offset_p[lane_idx] <= v2c_tile_offset_c[lane_idx];
        v2c_comp_p[lane_idx] <= v2c_comp_next[lane_idx];
        v2c_sign_p[lane_idx] <= v2c_sign_wdata[lane_idx];
        decision_we_p[lane_idx] <= decision_we_c[lane_idx];
        posterior_sign_p[lane_idx] <= posterior_sign_c[lane_idx];
        v2c_bypass_valid_b[lane_idx] <= v2c_valid_p[lane_idx];
        v2c_bypass_row_addr_b[lane_idx] <= v2c_row_addr_p[lane_idx];
        v2c_bypass_comp_b[lane_idx] <= v2c_comp_p[lane_idx];
        ksign_scan_row_addr_r[lane_idx] <= ksign_scan_row_addr[lane_idx];
      end
    end
  end

  ram_syndrome u_ram_syndrome (
      .i_clk        (i_clk),
      .i_rst_n      (rst_n_sync),
      .i_we         (syndrome_write_enable),
      .i_wr_addr    (i_syndrome_addr),
      .i_wr_data    (i_syndrome_wdata),
      .i_rd_valid   (c2v_valid),
      .i_rd_row_addr(c2v_row_addr),
      .o_rd_data    (syndrome_rdata)
  );

  always_ff @(posedge i_clk or negedge rst_n_sync) begin
    if (!rst_n_sync) begin
      syndrome_loaded <= 1'b0;
      syndrome_expected_addr <= '0;
    end else if (decode_start) begin
      syndrome_loaded <= 1'b0;
      syndrome_expected_addr <= '0;
    end else if (syndrome_write_enable) begin
      if ((CFG_R_W'(i_syndrome_addr) + CFG_R_W'(1)) == cfg_r) begin
        syndrome_loaded <= 1'b1;
        syndrome_expected_addr <= '0;
      end else begin
        syndrome_expected_addr <= syndrome_expected_addr + ROW_IDX_W'(1);
      end
    end
  end

  always_ff @(posedge i_clk or negedge rst_n_sync) begin
    if (!rst_n_sync) begin
      comp_read_pair_sel  <= 1'b0;
      comp_write_pair_sel <= 1'b1;
    end else begin
      if (decode_start) begin
        comp_read_pair_sel  <= 1'b0;
        comp_write_pair_sel <= 1'b1;
      end else if (iter_last_cycle) begin
        comp_read_pair_sel  <= comp_write_pair_sel;
        comp_write_pair_sel <= comp_read_pair_sel;
      end
    end
  end
endmodule
