z2901550610/Min_Sum/rtl/trike_poly_mul_karatsuba_core.sv

`timescale 1ns / 1ps

// Fixed-schedule one-level Karatsuba dense multiplier in
// GF(2)[x]/(x^R_BITS - 1). Operands are split into logical low/high halves.
// One Comba datapath sequentially computes Z0, Z2, and Z1. Each shifted
// subproduct word is cyclically folded into an independent WORDS-word result
// RAM. External operands use in-place XOR scans and are restored before output;
// the internal stream binding uses separate, unchanged low/high banks.
// Fold addresses and optional second-word RMW depend only on public geometry.
module trike_poly_mul_karatsuba_core #(
    parameter int R_BITS = 15581,
    parameter int WORD_W = 64,
    parameter int BASE_KARATSUBA_DEPTH = (WORD_W == 64) ? 2 : 1,
    parameter bit EXTERNAL_OPERANDS = 1'b0,
    parameter bit EXTERNAL_RESULT = 1'b0,
    parameter bit RUNTIME_GEOMETRY = 1'b0,
    parameter int ADDR_W = (((R_BITS + WORD_W - 1) / WORD_W) > 1) ? $clog2(
        (R_BITS + WORD_W - 1) / WORD_W
    ) : 1
) (
    input  logic              i_clk,
    input  logic              i_rst_n,
    input  logic              i_start,
    // Compile-time RAM bindings leave the other binding inputs inactive.
    /* verilator lint_off UNUSEDSIGNAL */
    input  logic [      31:0] i_runtime_r_bits,
    input  logic [      31:0] i_runtime_words,
    output logic              o_operand_re,
    output logic [ADDR_W-1:0] o_a0_addr,
    output logic [ADDR_W-1:0] o_b0_addr,
    input  logic [WORD_W-1:0] i_a0_data,
    input  logic [WORD_W-1:0] i_b0_data,
    output logic              o_operand_we,
    output logic [ADDR_W-1:0] o_operand_waddr,
    output logic [WORD_W-1:0] o_operand_a_wdata,
    output logic [WORD_W-1:0] o_operand_b_wdata,
    output logic              o_acc_we,
    output logic              o_acc_re,
    output logic [ADDR_W-1:0] o_acc_waddr,
    output logic [ADDR_W-1:0] o_acc_raddr,
    output logic [WORD_W-1:0] o_acc_wdata,
    input  logic [WORD_W-1:0] i_acc_rdata,
    /* verilator lint_on UNUSEDSIGNAL */
    input  logic              i_a_valid,
    input  logic [WORD_W-1:0] i_a_data,
    output logic              o_a_ready,
    input  logic              i_b_valid,
    input  logic [WORD_W-1:0] i_b_data,
    output logic              o_b_ready,
    output logic              o_result_valid,
    output logic [WORD_W-1:0] o_result_data,
    output logic              o_result_last,
    input  logic              i_result_ready,
    output logic              o_busy,
    output logic              o_done
);

  localparam int WORDS = (R_BITS + WORD_W - 1) / WORD_W;
  localparam int HALF_WORDS = (WORDS + 1) / 2;
  localparam int LAST_BITS = R_BITS - ((WORDS - 1) * WORD_W);
  localparam int HALF_ADDR_W = (HALF_WORDS > 1) ? $clog2(HALF_WORDS) : 1;
  localparam int RESULT_ADDR_W = (WORDS > 1) ? $clog2(WORDS) : 1;

  integer active_words_q, active_half_q, active_last_bits_q;
  logic [WORD_W-1:0] active_mask_c;
  /* verilator lint_off UNUSEDSIGNAL */
  logic a0_mask_q, b0_mask_q, a_pad_q, b_pad_q;
  /* verilator lint_on UNUSEDSIGNAL */
  typedef enum logic [4:0] {
    ST_IDLE,
    ST_LOAD_A,
    ST_PAD_A,
    ST_LOAD_B,
    ST_PAD_B,
    ST_CLEAR_RESULT,
    ST_SUB_PREFETCH,
    ST_SUB_WAIT,
    ST_MIX_READ_0,
    ST_MIX_WRITE_0,
    ST_MIX_READ_1,
    ST_MIX_WRITE_1,
    ST_SUB_ADVANCE,
    ST_XOR_READ_LOW,
    ST_XOR_READ_HIGH,
    ST_XOR_WRITE,
    ST_OUTPUT_FETCH,
    ST_OUTPUT_VALID
  } state_t;

  state_t state_q;
  // One-word producer/consumer rendezvous: operands and result use independent
  // RAMs. A completed diagonal waits in its accumulator until folding accepts it.
  typedef enum logic [1:0] {
    PROD_IDLE,
    PROD_PREFETCH,
    PROD_ACCUM,
    PROD_READY
  } prod_state_t;
  prod_state_t prod_state_q;
  logic product_valid_c, product_take_c;
  logic [WORD_W-1:0] product_low_c, product_high_c;
  logic restore_q;
  logic [WORD_W-1:0] xor_a_low_q, xor_b_low_q;
  integer ext_a_addr_c, ext_b_addr_c;

  integer                     word_idx_q;
  integer                     clear_idx_q;
  integer                     phase_q;
  integer                     diagonal_idx_q;
  integer                     a_word_idx_q;
  integer                     b_word_idx_q;
  integer                     sub_word_idx_q;
  integer                     output_idx_q;

  logic                       sub_is_carry_q;
  logic                       mix_term_q;
  logic   [       WORD_W-1:0] diagonal_low_q;
  logic   [       WORD_W-1:0] diagonal_high_q;
  logic   [       WORD_W-1:0] sub_word_q;

  // Internal bank controls are pruned by the external operand binding.
  /* verilator lint_off UNUSEDSIGNAL */
  logic                       a0_we;
  logic   [  HALF_ADDR_W-1:0] a0_waddr;
  logic   [       WORD_W-1:0] a0_wdata;
  logic                       a0_re;
  logic   [  HALF_ADDR_W-1:0] a0_raddr;
  logic   [       WORD_W-1:0] a0_rdata;
  logic                       a1_we;
  logic   [  HALF_ADDR_W-1:0] a1_waddr;
  logic   [       WORD_W-1:0] a1_wdata;
  logic                       a1_re;
  logic   [  HALF_ADDR_W-1:0] a1_raddr;
  logic   [       WORD_W-1:0] a1_rdata;
  logic                       b0_we;
  logic   [  HALF_ADDR_W-1:0] b0_waddr;
  logic   [       WORD_W-1:0] b0_wdata;
  logic                       b0_re;
  logic   [  HALF_ADDR_W-1:0] b0_raddr;
  logic   [       WORD_W-1:0] b0_rdata;
  logic                       b1_we;
  logic   [  HALF_ADDR_W-1:0] b1_waddr;
  logic   [       WORD_W-1:0] b1_wdata;
  logic                       b1_re;
  logic   [  HALF_ADDR_W-1:0] b1_raddr;
  logic   [       WORD_W-1:0] b1_rdata;

  /* verilator lint_on UNUSEDSIGNAL */
  logic                       result_we;
  logic   [RESULT_ADDR_W-1:0] result_waddr;
  logic   [       WORD_W-1:0] result_wdata;
  logic                       result_re;
  logic   [RESULT_ADDR_W-1:0] result_raddr;
  logic   [       WORD_W-1:0] result_rdata;

  logic   [       WORD_W-1:0] base_a_c;
  logic   [       WORD_W-1:0] base_b_c;
  logic   [   (2*WORD_W)-1:0] base_product_c;
  integer                     mix_word_idx_c;
  logic   [RESULT_ADDR_W-1:0] fold_addr0_c;
  logic   [RESULT_ADDR_W-1:0] fold_addr1_c;
  logic   [       WORD_W-1:0] fold_data0_c;
  logic   [       WORD_W-1:0] fold_data1_c;
  logic                       fold_second_c;
  logic                       pair_end_c;

  generate
    if (!EXTERNAL_OPERANDS) begin : g_operand_ram
      ram_bram #(
          .DATA_W(WORD_W),
          .DEPTH (HALF_WORDS)
      ) u_a0_mem (
          .i_clk  (i_clk),
          .i_we   (a0_we),
          .i_waddr(a0_waddr),
          .i_wdata(a0_wdata),
          .i_re   (a0_re),
          .i_raddr(a0_raddr),
          .o_rdata(a0_rdata)
      );

      ram_bram #(
          .DATA_W(WORD_W),
          .DEPTH (HALF_WORDS)
      ) u_a1_mem (
          .i_clk  (i_clk),
          .i_we   (a1_we),
          .i_waddr(a1_waddr),
          .i_wdata(a1_wdata),
          .i_re   (a1_re),
          .i_raddr(a1_raddr),
          .o_rdata(a1_rdata)
      );

      ram_bram #(
          .DATA_W(WORD_W),
          .DEPTH (HALF_WORDS)
      ) u_b0_mem (
          .i_clk  (i_clk),
          .i_we   (b0_we),
          .i_waddr(b0_waddr),
          .i_wdata(b0_wdata),
          .i_re   (b0_re),
          .i_raddr(b0_raddr),
          .o_rdata(b0_rdata)
      );

      ram_bram #(
          .DATA_W(WORD_W),
          .DEPTH (HALF_WORDS)
      ) u_b1_mem (
          .i_clk  (i_clk),
          .i_we   (b1_we),
          .i_waddr(b1_waddr),
          .i_wdata(b1_wdata),
          .i_re   (b1_re),
          .i_raddr(b1_raddr),
          .o_rdata(b1_rdata)
      );

    end else begin : g_external_operands
      assign a0_rdata = a_pad_q ? '0 : (a0_mask_q ? (i_a0_data & active_mask_c) : i_a0_data);
      assign b0_rdata = b_pad_q ? '0 : (b0_mask_q ? (i_b0_data & active_mask_c) : i_b0_data);
      assign a1_rdata = '0;
      assign b1_rdata = '0;
    end
  endgenerate
  generate
    if (!EXTERNAL_RESULT) begin : g_result_ram
      ram_bram #(
          .DATA_W(WORD_W),
          .DEPTH (WORDS)
      ) u_result_mem (
          .i_clk  (i_clk),
          .i_we   (result_we),
          .i_waddr(result_waddr),
          .i_wdata(result_wdata),
          .i_re   (result_re),
          .i_raddr(result_raddr),
          .o_rdata(result_rdata)
      );

    end else begin : g_external_result
      assign result_rdata = i_acc_rdata;
    end
  endgenerate
  assign o_operand_re = a0_re;
  always_comb begin
    ext_a_addr_c = int'(a0_raddr) + ((phase_q == 1) ? active_half_q : 0);
    ext_b_addr_c = int'(b0_raddr) + ((phase_q == 1) ? active_half_q : 0);
    if ((state_q == ST_XOR_READ_LOW) || (state_q == ST_XOR_READ_HIGH)) begin
      ext_a_addr_c = word_idx_q + ((state_q == ST_XOR_READ_HIGH) ? active_half_q : 0);
      ext_b_addr_c = ext_a_addr_c;
    end
  end
  assign o_a0_addr = (ext_a_addr_c < active_words_q) ? ADDR_W'(ext_a_addr_c) : '0;
  assign o_b0_addr = (ext_b_addr_c < active_words_q) ? ADDR_W'(ext_b_addr_c) : '0;
  assign o_operand_we = EXTERNAL_OPERANDS && (state_q == ST_XOR_WRITE);
  assign o_operand_waddr = ADDR_W'(word_idx_q);
  assign o_operand_a_wdata = xor_a_low_q ^ a0_rdata;
  assign o_operand_b_wdata = xor_b_low_q ^ b0_rdata;
  assign o_acc_we = result_we;
  assign o_acc_re = result_re;
  assign o_acc_waddr = result_waddr;
  assign o_acc_raddr = result_raddr;
  assign o_acc_wdata = result_wdata;
  assign active_mask_c = {WORD_W{1'b1}} >> (WORD_W - active_last_bits_q);
  always_ff @(posedge i_clk) begin
    if (a0_re) begin
      a0_mask_q <= ext_a_addr_c == active_words_q - 1;
      b0_mask_q <= ext_b_addr_c == active_words_q - 1;
      a_pad_q   <= ext_a_addr_c >= active_words_q;
      b_pad_q   <= ext_b_addr_c >= active_words_q;
    end
  end
  trike_clmul_karatsuba #(
      .WIDTH (WORD_W),
      .LEVELS(BASE_KARATSUBA_DEPTH)
  ) u_base_multiplier (
      .i_a      (base_a_c),
      .i_b      (base_b_c),
      .o_product(base_product_c)
  );

  assign product_valid_c = (prod_state_q == PROD_READY) ||
      ((prod_state_q == PROD_ACCUM) && pair_end_c);
  assign product_take_c = product_valid_c && ((state_q == ST_SUB_WAIT) ||
      ((state_q == ST_SUB_ADVANCE) && !sub_is_carry_q));
  assign product_low_c = diagonal_low_q ^
      ((prod_state_q == PROD_ACCUM) ? base_product_c[WORD_W-1:0] : '0);
  assign product_high_c = diagonal_high_q ^
      ((prod_state_q == PROD_ACCUM) ? base_product_c[(2*WORD_W)-1:WORD_W] : '0);

  always_comb begin
    unique case (phase_q)
      0: begin
        base_a_c = a0_rdata;
        base_b_c = b0_rdata;
      end
      1: begin
        base_a_c = a1_rdata;
        base_b_c = b1_rdata;
      end
      default: begin
        base_a_c = a0_rdata ^ a1_rdata;
        base_b_c = b0_rdata ^ b1_rdata;
      end
    endcase

    if (EXTERNAL_OPERANDS) begin
      base_a_c = a0_rdata;
      base_b_c = b0_rdata;
    end

    pair_end_c = (b_word_idx_q == 0) || (a_word_idx_q == (active_half_q - 1));

    mix_word_idx_c = sub_word_idx_q;
    if (mix_term_q || (phase_q == 2)) begin
      mix_word_idx_c = sub_word_idx_q + active_half_q;
    end else if (phase_q == 1) begin
      mix_word_idx_c = sub_word_idx_q + (2 * active_half_q);
    end

    // Reduction and recombination are linear over GF(2). Recombination terms
    // above degree 2*R_BITS-1 cancel in the complete product, so truncate them
    // consistently instead of wrapping padded intermediate terms a second time.
    // Every retained word produces at most two masked result contributions.
    fold_addr0_c  = '0;
    fold_addr1_c  = '0;
    fold_data0_c  = '0;
    fold_data1_c  = '0;
    fold_second_c = 1'b0;
    if (mix_word_idx_c < active_words_q) begin
      fold_addr0_c = RESULT_ADDR_W'(mix_word_idx_c);
      fold_data0_c = sub_word_q;
      if ((active_last_bits_q != WORD_W) && (mix_word_idx_c == (active_words_q - 1))) begin
        fold_second_c = 1'b1;
        fold_data1_c  = sub_word_q >> active_last_bits_q;
      end
    end else begin
      if ((mix_word_idx_c - active_words_q) < active_words_q) begin
        fold_addr0_c = RESULT_ADDR_W'(mix_word_idx_c - active_words_q);
        fold_data0_c = sub_word_q << (WORD_W - active_last_bits_q);
      end
      if ((active_last_bits_q != WORD_W) && ((mix_word_idx_c - active_words_q + 1) < active_words_q)) begin
        fold_second_c = 1'b1;
        fold_addr1_c  = RESULT_ADDR_W'(mix_word_idx_c - active_words_q + 1);
        fold_data1_c  = sub_word_q >> active_last_bits_q;
      end
    end
    if (fold_addr0_c == RESULT_ADDR_W'(active_words_q - 1)) fold_data0_c &= active_mask_c;
    if (fold_addr1_c == RESULT_ADDR_W'(active_words_q - 1)) fold_data1_c &= active_mask_c;
  end

  always_comb begin
    a0_we = 1'b0;
    a0_waddr = '0;
    a0_wdata = '0;
    a0_re = 1'b0;
    a0_raddr = '0;
    a1_we = 1'b0;
    a1_waddr = '0;
    a1_wdata = '0;
    a1_re = 1'b0;
    a1_raddr = '0;
    b0_we = 1'b0;
    b0_waddr = '0;
    b0_wdata = '0;
    b0_re = 1'b0;
    b0_raddr = '0;
    b1_we = 1'b0;
    b1_waddr = '0;
    b1_wdata = '0;
    b1_re = 1'b0;
    b1_raddr = '0;
    result_we = 1'b0;
    result_waddr = '0;
    result_wdata = '0;
    result_re = 1'b0;
    result_raddr = '0;

    unique case (state_q)
      ST_LOAD_A: begin
        if (i_a_valid) begin
          if (word_idx_q < active_half_q) begin
            a0_we = 1'b1;
            a0_waddr = HALF_ADDR_W'(word_idx_q);
            a0_wdata = (word_idx_q == (active_words_q - 1)) ? (i_a_data & active_mask_c) : i_a_data;
          end else begin
            a1_we = 1'b1;
            a1_waddr = HALF_ADDR_W'(word_idx_q - active_half_q);
            a1_wdata = (word_idx_q == (active_words_q - 1)) ? (i_a_data & active_mask_c) : i_a_data;
          end
        end
      end

      ST_PAD_A: begin
        a1_we = 1'b1;
        a1_waddr = HALF_ADDR_W'(active_half_q - 1);
      end

      ST_LOAD_B: begin
        if (i_b_valid) begin
          if (word_idx_q < active_half_q) begin
            b0_we = 1'b1;
            b0_waddr = HALF_ADDR_W'(word_idx_q);
            b0_wdata = (word_idx_q == (active_words_q - 1)) ? (i_b_data & active_mask_c) : i_b_data;
          end else begin
            b1_we = 1'b1;
            b1_waddr = HALF_ADDR_W'(word_idx_q - active_half_q);
            b1_wdata = (word_idx_q == (active_words_q - 1)) ? (i_b_data & active_mask_c) : i_b_data;
          end
        end
      end

      ST_PAD_B: begin
        b1_we = 1'b1;
        b1_waddr = HALF_ADDR_W'(active_half_q - 1);
      end

      ST_CLEAR_RESULT: begin
        result_we = 1'b1;
        result_waddr = RESULT_ADDR_W'(clear_idx_q);
      end

      ST_XOR_READ_LOW, ST_XOR_READ_HIGH: begin
        a0_re = 1'b1;
        b0_re = 1'b1;
      end

      ST_SUB_PREFETCH: begin
        a0_re = 1'b1;
        a1_re = 1'b1;
        b0_re = 1'b1;
        b1_re = 1'b1;
      end

      ST_MIX_READ_0: begin
        result_re = 1'b1;
        result_raddr = fold_addr0_c;
      end

      ST_MIX_WRITE_0: begin
        result_we = 1'b1;
        result_waddr = fold_addr0_c;
        result_wdata = result_rdata ^ fold_data0_c;
      end

      ST_MIX_READ_1: begin
        result_re = 1'b1;
        result_raddr = fold_addr1_c;
      end

      ST_MIX_WRITE_1: begin
        result_we = 1'b1;
        result_waddr = fold_addr1_c;
        result_wdata = result_rdata ^ fold_data1_c;
      end

      ST_OUTPUT_FETCH: begin
        result_re = 1'b1;
        result_raddr = RESULT_ADDR_W'(output_idx_q);
      end

      default: begin
      end
    endcase
    // The producer continues while the main FSM folds the previous word.
    // No operand writes occur until the producer and folder finish the phase.
    if ((prod_state_q == PROD_PREFETCH) || ((prod_state_q == PROD_ACCUM) && !pair_end_c)) begin
      a0_re = 1'b1;
      a1_re = 1'b1;
      b0_re = 1'b1;
      b1_re = 1'b1;
      a0_raddr = HALF_ADDR_W'(a_word_idx_q + ((prod_state_q == PROD_ACCUM) ? 1 : 0));
      a1_raddr = a0_raddr;
      b0_raddr = HALF_ADDR_W'(b_word_idx_q - ((prod_state_q == PROD_ACCUM) ? 1 : 0));
      b1_raddr = b0_raddr;
    end
  end

  assign o_a_ready = (state_q == ST_LOAD_A);
  assign o_b_ready = (state_q == ST_LOAD_B);
  assign o_result_valid = (state_q == ST_OUTPUT_VALID);
  assign o_result_data = result_rdata;
  assign o_result_last = (output_idx_q == (active_words_q - 1));
  assign o_busy = (state_q != ST_IDLE);

  always_ff @(posedge i_clk or negedge i_rst_n) begin
    if (!i_rst_n) begin
      active_words_q <= WORDS;
      active_half_q <= HALF_WORDS;
      active_last_bits_q <= LAST_BITS;
      state_q <= ST_IDLE;
      prod_state_q <= PROD_IDLE;
      word_idx_q <= 0;
      clear_idx_q <= 0;
      phase_q <= 0;
      diagonal_idx_q <= 0;
      a_word_idx_q <= 0;
      b_word_idx_q <= 0;
      sub_word_idx_q <= 0;
      output_idx_q <= 0;
      sub_is_carry_q <= 1'b0;
      mix_term_q <= 1'b0;
      diagonal_low_q <= '0;
      diagonal_high_q <= '0;
      sub_word_q <= '0;
      restore_q <= 1'b0;
      xor_a_low_q <= '0;
      xor_b_low_q <= '0;
      o_done <= 1'b0;
    end else begin
      o_done <= 1'b0;

      // Each phase starts after operand transformation, and retires only after
      // the final carry word has been consumed and folded. No data-dependent exit.
      if (state_q == ST_SUB_PREFETCH) begin
        diagonal_idx_q <= 0;
        a_word_idx_q <= 0;
        b_word_idx_q <= 0;
        diagonal_low_q <= '0;
        diagonal_high_q <= '0;
        prod_state_q <= PROD_ACCUM;
      end else if (product_take_c) begin
        if (diagonal_idx_q == (2 * active_half_q - 1)) begin
          prod_state_q <= PROD_IDLE;
        end else begin
          diagonal_idx_q  <= diagonal_idx_q + 1;
          diagonal_low_q  <= product_high_c;
          diagonal_high_q <= '0;
          if (diagonal_idx_q == (2 * active_half_q - 2)) begin
            prod_state_q <= PROD_READY;
          end else begin
            prod_state_q <= PROD_PREFETCH;
            if (diagonal_idx_q + 1 < active_half_q) begin
              a_word_idx_q <= 0;
              b_word_idx_q <= diagonal_idx_q + 1;
            end else begin
              a_word_idx_q <= diagonal_idx_q + 1 - (active_half_q - 1);
              b_word_idx_q <= active_half_q - 1;
            end
          end
        end
      end else if (prod_state_q == PROD_PREFETCH) begin
        prod_state_q <= PROD_ACCUM;
      end else if (prod_state_q == PROD_ACCUM) begin
        diagonal_low_q  <= product_low_c;
        diagonal_high_q <= product_high_c;
        if (pair_end_c) begin
          prod_state_q <= PROD_READY;
        end else begin
          a_word_idx_q <= a_word_idx_q + 1;
          b_word_idx_q <= b_word_idx_q - 1;
        end
      end
      if (product_take_c) begin
        sub_word_idx_q <= diagonal_idx_q;
        sub_word_q <= product_low_c;
        sub_is_carry_q <= (diagonal_idx_q == (2 * active_half_q - 1));
        mix_term_q <= 1'b0;
      end

      unique case (state_q)
        ST_IDLE: begin
          if (i_start) begin
            word_idx_q <= 0;
            active_words_q <= RUNTIME_GEOMETRY ? int'(i_runtime_words) : WORDS;
            active_half_q <= RUNTIME_GEOMETRY ? ((int'(i_runtime_words) + 1) / 2) : HALF_WORDS;
            active_last_bits_q <= RUNTIME_GEOMETRY ? int'(i_runtime_r_bits)-(int'(i_runtime_words)-1)*WORD_W : LAST_BITS;
            clear_idx_q <= 0;
            state_q <= EXTERNAL_OPERANDS ? ST_CLEAR_RESULT : ST_LOAD_A;
          end
        end

        ST_LOAD_A: begin
          if (i_a_valid) begin
            if (word_idx_q == (active_words_q - 1)) begin
              word_idx_q <= 0;
              state_q <= ((active_words_q % 2) != 0) ? ST_PAD_A : ST_LOAD_B;
            end else begin
              word_idx_q <= word_idx_q + 1;
            end
          end
        end

        ST_PAD_A: begin
          state_q <= ST_LOAD_B;
        end

        ST_LOAD_B: begin
          if (i_b_valid) begin
            if (word_idx_q == (active_words_q - 1)) begin
              clear_idx_q <= 0;
              state_q <= ((active_words_q % 2) != 0) ? ST_PAD_B : ST_CLEAR_RESULT;
            end else begin
              word_idx_q <= word_idx_q + 1;
            end
          end
        end

        ST_PAD_B: begin
          clear_idx_q <= 0;
          state_q <= ST_CLEAR_RESULT;
        end

        ST_CLEAR_RESULT: begin
          if (clear_idx_q == (active_words_q - 1)) begin
            phase_q <= 0;
            state_q <= ST_SUB_PREFETCH;
          end else begin
            clear_idx_q <= clear_idx_q + 1;
          end
        end

        ST_SUB_PREFETCH: state_q <= ST_SUB_WAIT;

        ST_SUB_WAIT: begin
          if (product_valid_c) state_q <= ST_MIX_READ_0;
        end

        ST_MIX_READ_0: begin
          state_q <= ST_MIX_WRITE_0;
        end

        ST_MIX_WRITE_0: begin
          if (fold_second_c) begin
            state_q <= ST_MIX_READ_1;
          end else if ((phase_q != 2) && !mix_term_q) begin
            mix_term_q <= 1'b1;
            state_q <= ST_MIX_READ_0;
          end else begin
            state_q <= ST_SUB_ADVANCE;
          end
        end

        ST_MIX_READ_1: begin
          state_q <= ST_MIX_WRITE_1;
        end

        ST_MIX_WRITE_1: begin
          if ((phase_q != 2) && !mix_term_q) begin
            mix_term_q <= 1'b1;
            state_q <= ST_MIX_READ_0;
          end else begin
            state_q <= ST_SUB_ADVANCE;
          end
        end

        ST_SUB_ADVANCE: begin
          if (sub_is_carry_q) begin
            if (phase_q == 2) begin
              output_idx_q <= 0;
              word_idx_q <= 0;
              restore_q <= 1'b1;
              state_q <= EXTERNAL_OPERANDS ? ST_XOR_READ_LOW : ST_OUTPUT_FETCH;
            end else begin
              phase_q <= phase_q + 1;
              word_idx_q <= 0;
              restore_q <= 1'b0;
              state_q <= (EXTERNAL_OPERANDS && phase_q == 1) ? ST_XOR_READ_LOW : ST_SUB_PREFETCH;
            end
          end else begin
            state_q <= product_valid_c ? ST_MIX_READ_0 : ST_SUB_WAIT;
          end
        end

        ST_XOR_READ_LOW: state_q <= ST_XOR_READ_HIGH;
        ST_XOR_READ_HIGH: begin
          xor_a_low_q <= a0_rdata;
          xor_b_low_q <= b0_rdata;
          state_q <= ST_XOR_WRITE;
        end
        ST_XOR_WRITE: begin
          if (word_idx_q == active_half_q - 1) begin
            state_q <= restore_q ? ST_OUTPUT_FETCH : ST_SUB_PREFETCH;
          end else begin
            word_idx_q <= word_idx_q + 1;
            state_q <= ST_XOR_READ_LOW;
          end
        end

        ST_OUTPUT_FETCH: begin
          state_q <= ST_OUTPUT_VALID;
        end

        ST_OUTPUT_VALID: begin
          if (i_result_ready) begin
            if (output_idx_q == (active_words_q - 1)) begin
              o_done  <= 1'b1;
              state_q <= ST_IDLE;
            end else begin
              output_idx_q <= output_idx_q + 1;
              state_q <= ST_OUTPUT_FETCH;
            end
          end
        end

        default: begin
          state_q <= ST_IDLE;
        end
      endcase
    end
  end

`ifndef SYNTHESIS
  initial begin
    if (R_BITS < 2) $error("trike_poly_mul_karatsuba_core R_BITS must be at least 2");
    if (WORD_W < 2) $error("trike_poly_mul_karatsuba_core WORD_W must be at least 2");
    if ((WORD_W % (1 << BASE_KARATSUBA_DEPTH)) != 0) begin
      $error("trike_poly_mul_karatsuba_core invalid base recursion depth");
    end
  end
`endif

endmodule
