z2901550610/Min_Sum/rtl/trike_keygen_arith_core.sv

`timescale 1ns / 1ps

// Fixed-schedule TRIKE KeyGen polynomial arithmetic.
//
// Inputs are the sparse h0/h1/h2 supports and dense t1/t2/r1 vectors. One
// general multiplier and one fixed-chain inverter execute:
//   t0 = (h0*r1 + h1) * inverse(t1 + r1)
//   r2 = (t0*t2 + h2) * inverse(t0 + h0)
// Operation counts and RAM scans depend only on public parameters.
module trike_keygen_arith_core #(
    parameter int R_BITS        = 15581,
    parameter int SECRET_WEIGHT = 35,
    parameter int WORD_W        = 64,

    parameter bit USE_EXTERNAL_MUL = 1'b0,
    parameter bit USE_EXTERNAL_H123_STORE = 1'b0,
    parameter bit USE_EXTERNAL_SUPPORT_STORE = 1'b0,
    parameter bit USE_EXTERNAL_RESULT_STORE = 1'b0,
    parameter int MUL_INDEX_W = ((R_BITS > 1) ? $clog2(R_BITS) : 1),
    parameter int WORD_ADDR_W = ((((R_BITS + WORD_W - 1) / WORD_W) > 1) ? $clog2(
        (R_BITS + WORD_W - 1) / WORD_W
    ) : 1)
) (
    input  logic i_clk,
    input  logic i_rst_n,
    input  logic i_support_valid,
    input  logic [1:0] i_support_block,
    input  logic [((SECRET_WEIGHT > 1) ? $clog2(SECRET_WEIGHT) : 1)-1:0] i_support_position,
    input  logic [((R_BITS > 1) ? $clog2(R_BITS) : 1)-1:0] i_support_index,
    input  logic [(3*SECRET_WEIGHT*((R_BITS > 1) ? $clog2(R_BITS) : 1))-1:0] i_support_store,
    output logic o_support_ready,
    input  logic i_vector_valid,
    input  logic [1:0] i_vector_select,
    input  logic [WORD_ADDR_W-1:0] i_vector_word,
    input  logic [WORD_W-1:0] i_vector_data,
    output logic o_vector_ready,
    input  logic i_start,
    output logic o_result_valid,
    output logic o_result_select,
    output logic [WORD_ADDR_W-1:0] o_result_word,
    output logic [WORD_W-1:0] o_result_data,
    output logic o_result_last,
    input  logic i_result_ready,
    output logic o_busy,
    output logic o_done,
    output logic o_mul_start,
    output logic [31:0] o_mul_runtime_r_bits,
    output logic [31:0] o_mul_runtime_words,
    output logic [31:0] o_mul_runtime_sparse_weight,
    output logic o_mul_sparse_a,
    output logic o_mul_a_valid,
    output logic [WORD_W-1:0] o_mul_a_data,
    input  logic i_mul_a_ready,
    output logic o_mul_sparse_index_valid,
    output logic [MUL_INDEX_W-1:0] o_mul_sparse_index,
    input  logic i_mul_sparse_index_ready,
    output logic o_mul_b_valid,
    output logic [WORD_W-1:0] o_mul_b_data,
    input  logic i_mul_b_ready,
    input  logic i_mul_result_valid,
    input  logic [WORD_W-1:0] i_mul_result_data,
    input  logic i_mul_result_last,
    output logic o_mul_result_ready,
    input  logic i_mul_done,
    output logic o_h123_t1_re,
    output logic [WORD_ADDR_W-1:0] o_h123_t1_raddr,
    /* verilator lint_off UNUSEDSIGNAL */
    input  logic [WORD_W-1:0] i_h123_t1_rdata,
    /* verilator lint_on UNUSEDSIGNAL */
    output logic o_h123_t1_we,
    output logic [WORD_ADDR_W-1:0] o_h123_t1_waddr,
    output logic [WORD_W-1:0] o_h123_t1_wdata,
    output logic o_h123_t2_re,
    output logic [WORD_ADDR_W-1:0] o_h123_t2_raddr,
    /* verilator lint_off UNUSEDSIGNAL */
    input  logic [WORD_W-1:0] i_h123_t2_rdata,
    /* verilator lint_on UNUSEDSIGNAL */
    output logic o_h123_r1_re,
    output logic [WORD_ADDR_W-1:0] o_h123_r1_raddr,
    /* verilator lint_off UNUSEDSIGNAL */
    input  logic [WORD_W-1:0] i_h123_r1_rdata,
    /* verilator lint_on UNUSEDSIGNAL */
    output logic o_store_t0_we,
    output logic [WORD_ADDR_W-1:0] o_store_t0_waddr,
    output logic [WORD_W-1:0] o_store_t0_wdata,
    output logic o_store_t0_re,
    output logic [WORD_ADDR_W-1:0] o_store_t0_raddr,
    /* verilator lint_off UNUSEDSIGNAL */
    input  logic [WORD_W-1:0] i_store_t0_rdata,
    /* verilator lint_on UNUSEDSIGNAL */
    output logic o_store_numerator_r2_we,
    output logic [WORD_ADDR_W-1:0] o_store_numerator_r2_waddr,
    output logic [WORD_W-1:0] o_store_numerator_r2_wdata,
    output logic o_store_numerator_r2_re,
    output logic [WORD_ADDR_W-1:0] o_store_numerator_r2_raddr,
    /* verilator lint_off UNUSEDSIGNAL */
    input  logic [WORD_W-1:0] i_store_numerator_r2_rdata
    /* verilator lint_on UNUSEDSIGNAL */
);
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
