z2901550610/Min_Sum/(commit log)

2026-03-26 在多个模块中移除对mdpc_demo_pkg的全局导入
2026-03-26 更新信号和状态变量名称
2026-03-26 移除无用的 valid_count 变量，更新相关逻辑以简化状态管理
2026-03-26 修改VNU模块以支持先验消息和累加逻辑
2026-04-01 修改VNU模块
2026-04-12 golden model支持BIKE参数
2026-04-16 优化仿真脚本
2026-04-16 优化模块注释，明确数据路径和消息格式的转换逻辑
2026-04-17 修复demo和paper冲突
2026-04-17 测试改为一次tb只跑一次译码，用脚本实现多次译码测试
2026-04-18 根据文档修改接口命名，VNU改为逐拍输出
2026-04-18 VNU实现论文跨流水架构
2026-04-20 全面BIKE移植
2026-04-20 修改命名，使其更直观
2026-04-20 Add script to generate QC first-column tables and update RTL testbenches
    - Introduced `gen_qc_first_columns.py` script to generate static first-column QC lane tables from `bike_pkg.H_BASE`.
    - Enhanced `run_bike_random.py` to include new RTL files and integrate first-column table generation.
    - Updated testbenches for `cnu_a`, `cnu_b`, `decoder_top`, and `h_shift` to reflect parameter name changes and improve clarity.
    - Added new testbenches for `msg_codec` and `ram_i` to validate functionality.
    - Refactored `tb_vnu` to replace legacy signal handling with new message passing conventions.
    [bike_pkg.sv, cnu_a.sv, cnu_b.sv, decoder_top.sv, msg_signmag_to_tc.sv, msg_tc_to_signmag_sat.sv, ram_i.sv, ram_m.sv]
2026-04-20 优化注释和变量命名
2026-04-20 Refactor RAM modules for simplified interfaces and enhanced debugging
    - Updated `ram_m`, `ram_s`, `ram_t`, and `ram_u` modules to streamline input/output signals, consolidating read/write operations into single ports.
    - Removed unnecessary bank and lane selections, simplifying memory access patterns.
    - Introduced debug memory outputs for easier verification of internal states during simulation.
    - Added a new testbench `tb_ram_blocks` to validate the functionality of all RAM modules collectively.
    - Enhanced `tb_decoder_top` to utilize new debug read functions for RAM modules, improving test coverage and error reporting.
    - Adjusted `tb_ram_i` to reflect the new interface changes, ensuring cons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
    [bike_pkg.sv, decoder_top.sv, ram_i.sv, ram_m.sv, ram_s.sv, ram_t.sv, tb_decoder_top.sv]
2026-04-21 添加 AGENTS.md 文档，更新 Makefile 以支持新的脚本，新增 run_quiet.py 和 verilator_quiet.py 脚本以优化命令运行，修改 run_bike_random.py 以使用新脚本，添加参考文档。
2026-04-21 优化io命名和注释
2026-04-21 实现论文中的二并行调度
2026-04-21 实现论文中双列乒乓调度
2026-04-21 重构控制逻辑
2026-04-21 优化命名和注释
2026-04-22 修改VNU
2026-04-25 VNU和两个格式转换模块修改完毕
2026-04-26 h shift修改完毕
2026-04-26 修复h shift的bug
2026-05-03 修改变量命名
2026-05-03 初始化改为从hex文件加载
2026-05-03 更新文档和代码以反映新的变量命名和参数调整，删除不再使用的模块和参数
2026-05-03 统一命名规范
2026-05-04 全部改为在开头使用`timescale
2026-05-04 删除ram u，修改ram t行为
2026-05-05 按照论文架构全面重构控制与流水
2026-05-08 重构解码器控制逻辑，统一列元数据处理，移除未使用信号
2026-05-09 优化RAM大小
2026-05-11 vivado适配
2026-05-11 bike pkg放到top中
2026-05-11 删除toy参数
2026-05-12 重构一些补丁代码
2026-05-12 优化解码器模块，调整状态地址计算和调试逻辑
2026-05-12 重构decoder_top模块，优化状态管理和地址计算逻辑
2026-05-12 将参数更改为局部参数以优化代码结构
2026-05-12 优化ram_t模块的内存管理逻辑，增强调试模式下的功能
2026-05-12 优化ram_t模块的内存分配策略，调整vivado_synth脚本以增强错误处理和报告功能
2026-05-12 优化decoder_top模块，增加残余综合跟踪逻辑并调整vivado_synth脚本以支持合成指令和层次扁平化设置
2026-05-14 修复超大io和lut问题
2026-05-17 Refactor code formatting and improve readability across multiple testbench files
    - Updated timescale formatting for consistency.
    - Aligned logic declarations for better readability.
    - Reformatted module instantiations for improved clarity.
    - Simplified function and task definitions by consolidating input parameters.
    - Enhanced error messages in assertions for better debugging.
    - Ensured consistent spacing and indentation throughout the code.
    [bike_pkg.sv, cnu_a.sv, cnu_b.sv, decoder_top.sv, msg_signmag_to_tc.sv, msg_tc_to_signmag_sat.sv, ram_i.sv]
2026-05-18 Add testbenches for decoder control and edge message pipe; refactor decoder top
    - Introduced `tb_decoder_ctrl.sv` to validate the functionality of the decoder control module, including state transitions and signal assertions.
    - Updated `tb_decoder_top.sv` to remove unused signals and streamline checks related to RAM-I and RAM-M interactions.
    - Added `tb_edge_message_pipe.sv` to test the edge message pipe module, ensuring correct handling of message passing and signal validity.
    - Refactored `tb_h_shift.sv` to adjust group depth calculations based on lane count instead of block count.
    - Modified `tb_ram_i.sv` to separate read and write block index signals for clarity and improved functionality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
    [bike_pkg.sv, decoder_top.sv, ram_i.sv, ram_m.sv, ram_s.sv, ram_syndrome.sv, ram_t.sv]
2026-05-18 修复vivado1
2026-05-19 修复vivado2
2026-05-19 修复vivado3
2026-05-19 修复vivado4
2026-05-19 修复vivado5
2026-05-20 修复BIKE解码器参数和测试用例，更新RAM初始化和验证逻辑
2026-05-23 Refactor RAM index handling and add new loader module
    - Removed unnecessary zero entries from RAM initialization files for l3, l4, l5, l6, and l7.
    - Updated h_shift module to improve row and group index calculations.
    - Introduced ram_i_idx_loader module for handling RAM index loading with first-column support.
    - Enhanced ram_s module for better debug address calculations.
    - Modified vnu module to implement a sum tree for cycle sums.
    - Added validation for parallel lane count to ensure it is a power of two.
    - Created a new Python script to generate deterministic toy decoder fixture.
    - Updated testbench files to integrate the new ram_i_idx_loader and validate its functionality.
    - Improved test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
    [bike_pkg.sv, decoder_top.sv, ram_s.sv, tb_decoder_top.sv, vnu.sv]
2026-05-27 更新参数设置以支持不同的解码器配置，优化 RAM 初始化和 VNU 模块的后验值计算
2026-05-27 优化解码控制逻辑，移除冗余状态，调整 VNU 处理流程以确保数据一致性
2026-05-28 重构时序表现，优化存储占用
2026-06-02 更新 BIKE-128 参数配置，优化 RAM 相关设置，增强综合脚本支持
2026-06-02 Fix Vivado RAM style synthesis compatibility
    [ram_m.sv, ram_s.sv, ram_syndrome.sv, ram_t.sv]
2026-06-04 Refactor bike package and add C2V schedule table
    - Updated the `bike_pkg` to change the localparam `R` from 73421 to 59069 and added several new localparams related to scheduling.
    - Introduced a new module `c2v_schedule_table` to manage the scheduling of row-bank issues based on the loaded first-column support.
    - Modified `decoder_top` to integrate the new scheduling logic, including signals for build status and lane outputs.
    - Enhanced `ram_m_bank_array` and `ram_syndrome` to support bank addressing for power-of-two configurations.
    - Updated testbench scripts to include the new scheduling functionality and ensure proper loading of H matrices.
    - Adjusted synthesis scripts to include the new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
    [bike_pkg.sv, decoder_top.sv, ram_syndrome.sv]
2026-06-05 重构支持优先译码器架构
2026-06-06 优化译码器硬件模块命名
2026-06-06 修复Vivado存储推断问题
2026-06-06 优化译码器布线友好的RAM访问
2026-06-06 优化128随机测试与综合RAM结构
2026-06-06 将主要译码存储改为同步BRAM
2026-06-07 优化译码器时序流水路径
2026-06-07 增加译码地址请求流水
2026-06-07 增加H读出到地址生成流水
2026-06-07 优化并行银行地址计算
2026-06-08 优化边地址生成时序
2026-06-09 用固定清空窗口优化校验状态存储
2026-06-13 优化译码器存储组织
2026-06-13 优化sign存储BRAM整字写回
2026-06-13 修复BRAM读路径和调度器时序
2026-06-13 更新RAM命名和参数结果
2026-06-15 Add unified decoder profile wiring
2026-06-15 Update random decoder test profile wiring
2026-06-16 为VNU更新加入固定深流水
2026-06-16 放开ram_s写侧寄存器优化
2026-06-17 加入ram_i和ram_s深流水
2026-06-17 保持ram_s写侧寄存器局部副本
2026-06-17 重构ram_s为全lane帧存储
2026-06-17 提高默认lane并行度到16
2026-06-17 默认综合统一参数硬件
2026-06-17 重构：profile参数去重，提取syndrome RAM为独立模块
    - bike_pkg.sv: 用 P_R/P_W/P_C/P_ASH/P_CTILE_VALS 查找数组统一 5 个 profile 的参数值，消除三处重复硬编码
    - decoder_profile_config.sv: case MUX 改为数组索引查找，从 89 行减至 40 行
    - ram_syndrome.sv: 从 decoder_top.sv 提取 banked syndrome RAM 为独立模块
    - decoder_top.sv: 移除 syndrome generate 块和 row_bank_of/row_addr_of 辅助函数
    - tb_ram_syndrome.sv: 新增 syndrome RAM 单元测试
    - Makefile: 加入 ram_syndrome.sv 到 RTL_CORE 和 test-unit
2026-06-17 ram_s: edge_base改直接乘法，read_chunk_q限制扇出
    - edge_base(): 手动位扫描循环改为 SIGN_BANK_AW'(edge_id) * SIGN_BANK_AW'(TILE_COUNT)
    - read_chunk_q: 添加 (* max_fanout = 16 *) 属性，降低 chunk 选择信号扇出
    - 目标：缓解 ram_s 关键路径（-0.434ns 违规），减少 CARRY8 链深度和 BRAM 使能路由延迟
2026-06-17 Revert "ram_s: edge_base改直接乘法，read_chunk_q限制扇出"
    This reverts commit e0f0c1b2fe583175614b5cbf8e381e817d3b264d.
    [ram_s.sv]
2026-06-17 XDC: u_ram_s Pblock约束消除SLR crossing，synth TCL补齐RTL列表
    - constraints/decoder_top.xdc: 时钟改为100MHz，添加u_ram_s的Pblock约束
    将sign storage BRAM和关联逻辑限制在单个SLR内，消除跨SLR路由惩罚(~4ns)
    - scripts/vivado_synth.tcl: 补齐ram_syndrome.sv、decoder_profile_config.sv、
    msg_tc_to_signmag_sat.sv、cnu_a.sv、cnu_b.sv、msg_signmag_to_tc.sv到RTL列表
2026-06-18 默认启用 L32 并更新延时优化目标
2026-07-09 refactor(ram_k_sign): 合并冗余的bank读取端口
2026-07-09 fix(ram_m): 修复符号翻转的读写冲突
2026-07-10 refactor(k_sign): 拆分K-sign存储为tile工作RAM与全局RAM
2026-07-10 refactor(ram_m): 统一读数据通路并修复翻转旁路逻辑
2026-07-10 refactor(ram_m): 提取 BRAM 为独立模块并使用 XPM
2026-07-10 refactor: 统一BRAM封装并优化交叉逻辑
2026-07-10 refactor(ram_i): 使用 BRAM 替代寄存器阵列并重构校验逻辑
2026-07-10 refactor(ram): 将 ram_decision 与 ram_syndrome 改为 BRAM 同步读
2026-07-10 refactor(ksign): 将全局 K-sign RAM 从双缓冲改为原地更新
2026-07-11 fix(decoder):寄存K-sign correction的写回信号
2026-07-11 feat(ram_bram): 新增MEMORY_PRIMITIVE参数以支持分布式RAM
2026-07-11 refactor(ram_bram): 使用USE_DISTRIBUTED参数替换MEMORY_PRIMITIVE
2026-07-13 feat(rtl): 引入桶形旋转器替换跨通道路由逻辑
2026-07-13 feat(ram_bram): 支持精确深度块RAM风格
2026-07-13 feat(decoder): 增加 K-sign 直接校正模式并更改默认 K 为 3
2026-07-13 perf(decoder): 流水线化 edge_addr_gen 及更新译码周期
    将 edge_addr_gen 模块重构为两级流水线结构：第一级寄存地址请求参数，
    第二级计算各 bank 的 lane 偏移与行地址。此更改引入额外一拍延迟，
    因此将译码周期公式 T_DECODE 的常数项从 4 更新为 5，并同步更新
    decoder_top 中的控制信号流水与测试用例。
2026-07-13 fix(解码器): 修正全局K-sign RAM时序与拆分实现
    将 `ram_k_global` 从宽 BRAM 拆分为独立窄 BRAM 以优化资源，并在
    `k_sign_correction` 中插入一级流水线寄存器以修正读取时序，同步
    更新译码周期预算公式由 +5 至 +6 及相应验证文档。
    [decoder_top.sv, ram_k_global.sv, tb_decoder_top.sv]
2026-07-13 refactor(ram_k_global): 按BRAM原生几何拆分dev_pos深度段
2026-07-13 refactor(ram_k_global): 合并 base_sign 与 slot 0 共用 BRAM 字段
2026-07-13 refactor(ram_t): 使用地址交织替代双实例双缓冲
2026-07-13 refactor: 移除 ram_t 地址交织并简化 k_sign_update 有效位逻辑
2026-07-13 docs(k_sign): 修复更新器无效槽比较并添加实现状态文档
2026-07-14 docs: add optimization exploration history and segment-based correction routing
    新增优化探索记录文档，记录已评估的架构与资源优化方案及取舍结论；
    同步更新 AGENTS.md 与 CLAUDE.md 的探索记录规则与文档索引；
    k_sign_correction 改为基于分段地址的单路直接读取，
    替换原有的多路 lane 索引读取；新增 ksd_t 类型与相关地址参数；
    补充 K-sign DFR 仿真结果数据。
    [ksign_results_summary.csv]
2026-07-14 回退到阶段性最佳时序版本
2026-07-15 feat(decoder): 实现 K-sign correction 跨 tile 重叠扫描
    将 K-sign correction 从串行执行改为与后续主窗口重叠并行，显著缩短固定周期：
    - 新增 ram_sign_delta 保存 deviation parity，与 ram_m 的 base parity 异或恢复近似符号
    - ram_k_tile 扩展为双工作 buffer，支持 correction 与 V2C 并行访问
    - 新增 k_sign_overlap_scheduler 生成独立 correction 扫描坐标
    - ram_i 扩展为三读视图，供 C2V、V2C 和 correction 同时使用
    - 每迭代固定尾部缩减为单个 tile 扫描窗口，TRIKE-512 周期从 23425443 降至 16641183
    [decoder_top.sv, k_sign_overlap_scheduler.sv, k_sign_selector.sv, ram_i.sv, ram_k_tile.sv, ram_sign_delta.sv, tb_k_sign_update.sv]
2026-07-15 refactor(ram_k_tile): 用21-bit位置snapshot替换双工作buffer
2026-07-15 refactor(ram_accum): 合并双读口为单共享读地址
2026-07-17 feat(ram_t): 使用tile-offset bank紧凑地址减少BRAM
2026-07-17 feat(ksign): 复用全局K记录base_sign作为最终判决
    删除K-sign配置中的ram_decision模块，译码完成后外部串行读口复用空闲的全局K记录读口，直接输出最终一轮提交的base_sign作为错误判决向量。full-sign配置保持原有ram_decision不变。
2026-07-17 feat(decoder): 实现装载/启动协议修复与ram_m字段拆分
2026-07-17 refactor(ram_m): 撤回9+9 bit字段拆分恢复完整18-bit记录
2026-07-21 feat(trike): 更新默认K-sign配置至L=32、K=4、1152列
    更新Makefile与RTL默认构建参数，将统一TRIKE K-sign基线从L=16、K=3、COLS_PER_TILE=1168
    升级至L=32、K=4、COLS_PER_TILE=1152。该配置通过五档随机译码回归与Vivado布线后时序验证，
    显著降低固定译码周期，BRAM利用率降至89.72%。同步更新实现状态、设计文档及DFR结果记录。
    [ksign_results_summary.csv]
2026-07-22 refactor(ksign): 将correction命中判断移至bank侧并返回1-bit结果
2026-07-25 feat(ram_k_global): 扩展K=4配对字段映射至L=16
    将 `USE_K4_PAIR_FIELDS` 的启用条件扩展至 `L=16`，使用两个 18-bit 配对字段保存 `base_sign` 和 `dev_pos`，消除独立 base-sign 存储并减少 16 个 RAMB36。同步更新相关设计文档、探索历史与实验数据。
    [ksign_results_summary.csv]
2026-07-25 refactor(ram_k_global): L=16改用4Kx9原生字段映射
    将L=16、K=4配置下的18-bit配对字段重构为四个4Kx9字段，保留L=32的2Kx18映射。
    统一使用参数化打包逻辑，降低L=16的段选择复杂度并保持BRAM容量不变。
2026-07-26 refactor(k_sign_selector): 提取公共bank地址并收窄旋转网络
    - 利用同一lane group内floor(tile_offset/L)相同的不变量，从主工作RAM和correction snapshot的前向旋转网络中删除逐lane重复的地址payload。
    - 主路径和correction路径分别计算一份公共读地址并广播到所有bank，只旋转valid、列号、V2C消息和base sign等bank相关负载。
    - 添加ifndef SYNTHESIS保护的仿真断言，检查有效lane的地址一致性。
    - 更新tb_k_sign_update测试，增加Q_BASE>1条件下的非零group地址和非零bank旋转覆盖。
    - 补充实现状态、设计文档与优化历史，记录L=16四9-bit字段方案的资源时序基线与后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
2026-07-26 refactor(ram_t): 收窄读写地址并广播公共地址
    同一lane group内tile offset不变量保证读写地址相同。地址不再随lane旋转，只旋转valid和消息payload，直接广播到所有bank。同时更新设计文档与物理复测基线。
2026-07-28 docs: 更新 TRIKE 参数与硬件设计说明
    - 新增面向初学者的译码器硬件设计指南
    - 更新 K=4 Min-Sum 与 TRIKE BF 的 FLS 外推文档
    - 修正 TRIKE 各参数等级的 R 值并同步周期与资源报告
    [bike_pkg.sv]
2026-07-28 feat(ram_accum): 广播公共地址并收窄前向旋转载荷
    在C2V读、C2V写和V2C读路径中提取公共地址广播到所有bank，前向旋转网络仅保留valid和写数据。同时更新新r参数下L=32的物理基线文档。
2026-08-03 Add TRIKE KEM hardware checkpoint
    Share the SM3 compression datapath, add fixed-schedule polynomial inversion and Vivado implementation wrappers, and extend reference tests. Synchronize TRIKE160/TRIKE256 decoder parameters and document the BIKE/TRIKE hardware mechanisms and validation boundaries.
    [bike_pkg.sv, hmac_sm3_64byte_key_stream.sv, sm3_df_stream.sv, sm3_hash_stream.sv, tb_trike_poly_inv_core.sv]
2026-08-04 feat(kem): add narrow-I/O pseudohash wrapper and fix XDC constraints
    新增64-bit result流输出的pseudohash封装层，将顶层I/O从528降至83，并增加result backpressure和last握手。XDC使用`get_ports -filter`静态集合表达式替代Tcl流程控制命令，适配Vivado工程模式。新增wrapper单元测试，更新Vivado首轮实现记录和文档。
    [tb_trike_pseudohash_synth_top.sv, trike_pseudohash_synth_top.sv]
2026-08-05 feat(docs): add Trike Encaps implementation and test documentation
    - 新增 Encaps 相关组件的 RTL 模块、testbench 和验证结果文档
    - 更新实现状态、优化探索历史、公共核文档，包含 H4 采样、u/v 计算和顶层调度
    - 更新 Makefile 添加 Encaps 单元测试、参考测试和 Vivado 实现入口
2026-08-05 feat(trike_encaps): 添加封装合成顶层、寄存器分段优化和物理基线文档
    - 添加 `trike_encaps_synth_top` 模块，实现8-bit输入缓冲和两级寄存输出边界
    - 为 `trike_h123_vectors` 的完成脉冲添加12路本地寄存器复制，降低高扇出
    - 为 `trike_poly_mul_core` 稀疏乘法的贡献值和地址添加流水寄存器
    - 更新XDC约束，使用独立的最大/最小输入输出延迟
    - 添加 `test-trike-encaps-synth-reference` 仿真目标
    - 扩展Vivado脚本以报告内部寄存器路径和高扇出网络
    - 更新文档以记录首轮物理基线和寄存器分段策略
2026-08-06 feat(build): add KeyGen core tests, synthesis targets, and docs
    添加 trike_keygen 完整硬件实现：固定16候选秘密采样、弱密钥检测、环算术微程序、顶层窄流wrapper，以及对应的仿真、Vivado综合入口与文档更新。
2026-08-06 refactor(keygen): 切断SK support动态索引路径，改用顺序输出RAM
    secret采样时并行写入稀疏视图、算术核与32-bit顺序输出RAM；SK阶段按固定地址fetch每个support word并输出四个little-endian byte。消除原32-bit扁平计数、除法、取模及105项二维动态索引，busy周期增加105拍。
2026-08-09 feat(trike): add Min-Sum decaps pipeline and verification targets
    - 新增 decaps syndrome、decoder 装载、固定长度验证边界模块
    - 新增 r=12589 固定求逆链与 Min-Sum KEM 项目向量生成
    - 新增 decoder 判决读回、padded error 存储模块
    - 新增 L/H4/compare/K 后处理闭环模块
    - 新增单 SM3 的统一 Decaps 后处理控制器
    - 新增 pipeline 顶层与 synth_top 参考测试目标
    - 更新 Makefile 构建、测试目标及文档实现状态
    [bike_pkg.sv, tb_trike_ct_verify_stream.sv, tb_trike_decaps_kdf_reference.sv, tb_trike_decaps_message_reference.sv]
2026-08-10 feat(trike): keep four submission profiles
    [ksign_results_summary.csv]
2026-08-24 feat(trike): share KEM weight sampler
2026-08-25 feat(trike): map sampler index store to block RAM
2026-08-25 docs(vivado): record sampler BRAM routed result
2026-08-27 feat(build): 添加多项式乘法Karatsuba测试目标与硬件优化分析文档
    - 在Makefile中引入TRIKE_POLY_DIGIT_W和TRIKE_POLY_KARATSUBA_DEPTH参数
    - 新增clmul、karatsuba和karatsuba2的仿真测试目标及矩阵测试
    - 将新增测试纳入test-kem-unit并支持对poly参考测试传递参数化配置
    - 添加TRIKE硬件优化分析文档，涵盖当前瓶颈、优化候选与实验计划
2026-08-27 feat(trike): 实现 TRIKE-2 短逆元链并归档历史设计文档
    - rtl/scripts 新增短逆元调度生成与 poly_inv_core 支持（EXP-0120），并记录两次 poly-mul 布线运行清单
    - 将过期设计、图形与恢复文件移入 docs/archive，同步更新 AGENTS.md 与 CLAUDE.md
    - 提取 scripts/trike_fixture_utils.py 共享 KAT fixture 派生逻辑，精简各生成脚本
2026-08-28 docs: 补充RTL工作流技能与本地工具链文档
    新增 `.agents/skills/` 下 8 个 RTL 工作阶段技能说明，统一 Makefile 入口
    （format/lint/compile/test/regress/formal/synth/qor/check/workflow-smoke），
    更新工具锁与本地环境基线，并补充 workflow、known-limitations、
    reset-and-clock 文档及 EXP-0121 实验记录。
    [workflow_counter.sv, workflow_counter_formal.sv]
2026-08-30 docs(agents): 强化 RTL 工作流技能与工具链指引
    [ksign_results_summary.csv]
2026-09-09 feat(trike): integrate Karatsuba-Comba direct cyclic folding
    Reuse operand RAM through fixed in-place XOR and restore scans, migrate dense multiplication and inversion callers, and retain sparse scheduling.
    Record local reference and full-size arithmetic checks. Runtime TRIKE160/256 passed; TRIKE384 was cancelled and TRIKE512 omitted at user request. Vivado remains NOT_RUN.
    [tb_trike_decaps_syndrome_reference.sv, tb_trike_decaps_syndrome_runtime.sv, tb_trike_decaps_syndrome_store_core.sv, tb_trike_encaps_core_reference.sv, tb_trike_keygen_arith_core.sv]
